Mocen-Bear/Mocen_Elevator_Ctrl/mech/renders/05_剖视_压下3mm.png

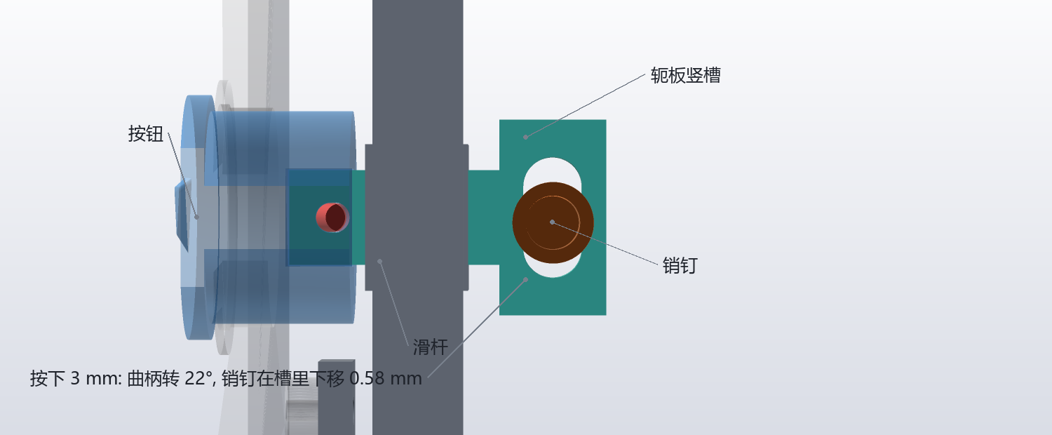
mech/renders/05_剖视_压下3mm.png
