Mocen-Bear/Mocen_Elevator_Ctrl/mech/renders/01_总装_正面.png

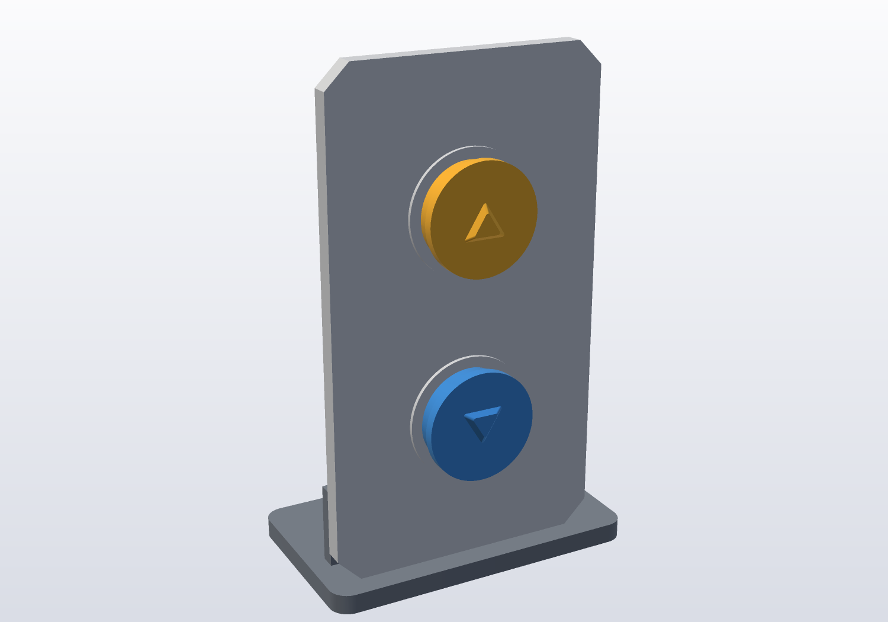
mech/renders/01_总装_正面.png
