Mocen-Bear/Mocen_Elevator_Ctrl/docs/README.md

# 文档索引

`docs/` 下所有文档的入口。按用途分三类：**协议接口**、**项目说明**、**子目录**。

---

## 协议与接口

| 文档 | 内容 |
|---|---|
| [`BLE_PROTOCOL.md`](BLE_PROTOCOL.md) | BLE 广播格式、服务/特征 UUID、命令与回执时序 |
| [`API.md`](API.md) | 对外接口约定（App 侧最小 HTTP 接口） |
| [`SHAFT_MODEL.md`](SHAFT_MODEL.md) | 井道 / 楼层空间模型与坐标约定 |
| [`NAV_APP_UI_SPEC.md`](NAV_APP_UI_SPEC.md) | 导航 App 界面规格（布局、状态、文案） |
| [`IOS_INTEGRATION.md`](IOS_INTEGRATION.md) | iOS 侧接入说明（同一套协议换实现） |

## 项目说明

| 文档 | 内容 |
|---|---|
| [`REPORT.md`](REPORT.md) | 项目技术报告（方案、取舍、实测数据） |
| [`HANDOVER.md`](HANDOVER.md) | 交接说明：现状、待办、红线 |
| [`术语表.md`](术语表.md) | 名词统一：井道、判层、合并镜像等 |

## 子目录

| 目录 | 内容 |
|---|---|
| [`android/`](android/) | App 安装说明与版本信息 |
| [`esp32/`](esp32/) | ESP32 开发环境搭建记录与环境交接 |
| [`media/`](media/) | 文档配图（接线、界面、3D 预览、增压装置） |
| [`项目资料/`](项目资料/) | 项目说明、技术说明、演示方案、分镜脚本 |
| [`演示材料/`](演示材料/) | 现场演示手册、能力与边界、版本信息 |

---

## 阅读顺序建议

1. 先看仓库根目录 [`README.md`](../README.md)，了解整体结构。
2. 想知道**怎么跑起来** → [`android/安装说明.md`](android/安装说明.md)、[`../firmware/烧录说明.md`](../firmware/烧录说明.md)。
3. 想知道**协议怎么对** → [`BLE_PROTOCOL.md`](BLE_PROTOCOL.md)。
4. 想知道**现场怎么讲** → [`演示材料/现场演示手册.md`](演示材料/)。
