Mocen-Bear/Mocen_Elevator_Ctrl/mech/参数与校验报告.md

# 演示样机 参数与校验报告 (v1)

> 由 `cad/build.py` 自动生成, 每次修改参数后重新生成。
> 坐标: X 右 / Y 上 / Z 朝墙里 (面板正面 Z=0)。单位 mm。

## 1. 关键尺寸

| 项目 | 数值 |
|---|---|
| 整机包围盒 | 82 宽 x 130 高 x 51 深 |
| 面板 | 70 x 125 x 5.0, 按钮孔 ⌀24.8, 上下中心距 51 |
| 按钮 | 帽 ⌀27.6 厚 2.6, 杆 ⌀24, 静止间隙 5, 工作行程 3, 硬限位 4 |
| 曲柄 | R=8, 厚 4.5, 轮毂 ⌀17, 花键孔 ⌀4.9, 销钉 ⌀6 |
| 轭槽 | 6.6 (行程向) x 13.6 (容差向), 销钉 6.0 -> 侧隙 0.6, 轴心高度容差 ±3.8 |
| 滑杆 | 5.0 x 10.6 |
| 舵机轴心 | Z=33.5 (比按钮中心低 8), 安装耳孔距 27.70 x2 |

## 2. 运动学

| 角度 | 行程 (mm) | 销钉中心下移 (mm) |
|---|---|---|
| 0° | 0.00 | 0.00 |
| 5° | 0.70 | 0.03 |
| 10° | 1.39 | 0.12 |
| 15° | 2.07 | 0.27 |
| 18° | 2.47 | 0.39 |
| 22° | 3.00 | 0.58 |
| 26° | 3.51 | 0.81 |
| 30° | 4.00 | 1.07 |

## 3. 干涉校验

在 0°~30° (行程 0~4 mm) 逐角度检查 4 个运动件 (曲柄+销钉 / 滑块 / 按钮 / 连接销)
它们**彼此之间**、以及每个与固定件 (底座 / 面板 / 舵机外形) 的布尔交集体积
(曲柄与销钉是设计上的过盈配合, 视为一个整体, 不互相检查)。

- 检查姿态数: **20**
- 最大干涉体积: **0.000000 mm³** -> **通过**
- 两层运动件 最小间隙: 23.40 mm

### 3.1 静止姿态实测间隙 (manifold 最小距离)

| 配合 | 实测间隙 |
|---|---|
| 销钉 ⌀6.0 → 竖槽侧壁 (槽宽 6.6) | 0.30 mm |
| 滑杆截面 → 按钮方孔 (5.4 x 11.0) | 0.20 mm |
| 滑杆截面 → 导向块方孔 (5.4 x 11.4) | 0.20 mm |
| 连接销 ⌀3.2 → 按钮横孔 ⌀3.4 | 0.10 mm |
| 连接销 → 滑杆横孔 | 0.10 mm |
| 按钮杆 ⌀24.0 → 面板孔 ⌀24.8 | 0.40 mm |
| 按钮后端 (z=11) → 导向块前端 (z=15.5) | 4.50 mm |
| 曲柄 (半径 13.5) → 底座 | 1.50 mm |
| 曲柄 + 销钉 → 舵机外形 | 0.00 mm |
| 轭板 → 底座导向块 | 0.20 mm |

## 4. 零件体积 (PLA 1.24 g/cm³)

| 零件 | 数量 | 体积 cm³ | 估重 g |
|---|---|---|---|
| 01_底座.stl | 1 | 33.42 | 41 |
| 02_面板.stl | 1 | 39.41 | 49 |
| 03_按钮_上.stl | 1 | 8.21 | 10 |
| 04_按钮_下.stl | 1 | 8.21 | 10 |
| 05_滑块.stl | 2 | 2.20 | 3 |
| 06_曲柄.stl | 2 | 1.01 | 1 |
| 07_销钉.stl | 2 | 0.59 | 1 |
| 08_连接销.stl | 2 | 0.25 | 0 |
| **合计** | **12 件** | **97.4** | **121** |

## 5. 结论

- 全行程无干涉, 全部零件均为单一水密实体, 可直接切片打印。
- 曲柄夹紧缝 + M3 夹紧螺丝: 可在装配时机械地对零, 无胶。
- 销钉为独立零件, 磨损/断裂只需重印 1 件, 不动曲柄。
- 竖槽 Y 向 ±3.8 mm 容差吸收舵机轴心高度误差。
