Mocen-Bear/Mocen_Elevator_Ctrl/docs/项目资料/01_说明文档.md

# 说明文档

> 本文件包含：项目名称 / 项目简介与功能说明 / 原创与版权声明 / 第三方标注。

---

## 一、项目名称

**中文名：电梯呼叫**
**英文名：Elevator Call**
**一句话副标题：基于蓝牙近场判层的"隔空按电梯"装置（ESP32 + 舵机 + Android）**

> 备选名（如需更项目化）：**「伸手」— 让电梯先听见你** / **ELEV-CALL 无接触呼梯**
> （最终用哪个名字，由项目维护者决定；本文件其余部分与名字无关。）

---

## 二、项目简介与功能说明

### 2.1 项目简介（300 字以内，可直接粘贴用）

> 在电梯厅外，人要做的事只有一件：**按一下呼梯按钮**。但对提着重物、抱着孩子、
> 或者暂时腾不出手的人来说，这一下并不轻松，也不卫生。
>
> 我们做了一套**零改造**的呼梯装置：手机 App 打开即自动扫描，用**蓝牙广播信号的强弱**
> 判断"你正站在哪一层、离井道多近"，然后把该层电梯的**真实呼梯按钮**用舵机按下去。
> 装置通身只有一个"贴在墙上"的 3D 打印支架 + 一块 ESP32 + 一个舵机，**不碰电梯任何线路**、
> **10 秒可拆**，全部**离线可用**、**零预算**。
>
> 关键是**我们不自称能做到做不到的事**：我们只按公共按钮、不控制电梯；
> 收到 `1F|OK:UP` 只代表"舵机动作完成"，**不代表轿厢动了**。
> 凡是我们测不到的（轿厢真实位置、还有几秒到），界面上要么不显示，要么明确标注来源。

### 2.2 功能说明（按"用户看到什么"写）

| # | 功能 | 用户看到 / 体验到什么 | 技术上是怎么做出来的 |
|---|---|---|---|
| 1 | **打开即用** | 打开 App 就开始工作，**不用配对、不用扫码、不用点"开始搜索"** | 手机持续扫描 BLE 广播（不建立连接），每扫到一次新广播就立刻重判，节流 40 ms |
| 2 | **自动认楼层** | 顶部层显自动变成"你所在楼层"（1F / 2F），3D 井道里对应楼层高亮 | 按 RSSI 强弱 + 中位数窗口 + EMA + 3 dB 滞回 + 连赢计数，四道防抖 |
| 3 | **隔空呼梯** | 点 **▲ 上行 / ▼ 下行**，该层的真按钮被**真的按下去** | 手机 → BLE 写 `UP`/`DOWN` → 该层 ESP32 → D13/D12 出 50 Hz PWM → 舵机转 22° 压按钮 |
| 4 | **真回执** | 界面提示 `1F \| OK:UP`（表示**舵机动作完成**） | ESP32 通过 Notify 特征**广播**回执，所有已订阅的手机都能收到 |
| 5 | **多人同时用** | 一块 ESP32 最多 **3 台手机**同时连接、各自控制，互不影响 | 固件 v5 起：断开一台不影响其它手机收通知 |
| 6 | **看得见的 3D 井道** | 可手指拖动旋转的 B–3F 电梯井；轿厢会动，到站自动开门；**只有 1F/2F 画全**，B/3F 是半透明虚影 | 安卓端软件渲染（自写投影 + painter 排序），几何常量与规格页逐条对齐 |
| 7 | **两台电梯** | 甲梯**跟着你**（你在哪层它就在哪层），乙梯**随机跑**（纯装饰） | 乙梯的随机**只发生在界面里**，接口里 `car2` 恒为 `null`（不知道就说不知道） |
| 8 | **给队友 App 的接口** | 队友的 iOS 导航 App 直接 HTTP 调 `/api/call?floor=1F&dir=UP` | 安卓端内置 `LocalApiServer`（8899），和点按钮**走同一条代码路径** |
| 9 | **安全红线（写进代码里的）** | 永远不会"自己乱按" | ① 全工程只有 **2 个**能发命令的入口（▲/▼ 按钮、HTTP 接口）；② 信号/判定回调里**一行发命令的代码都没有**；③ `tryCall()` 第一句就拒绝 B/3F；④ 换楼层只改 UI，从不自动呼梯 |

### 2.3 我们**明确做不到**的（主动写在最前面，也是设计的一部分）

| 做不到 | 为什么 | 我们怎么处理 |
|---|---|---|
| 测不出轿厢真实在哪层 | 两块 ESP32 只会"按按钮"，电梯不给我们任何反馈 | 界面**永远标来源**；没装传感器时明确是"蓝牙判层/模拟" |
| 控制不了电梯 | 没有授权、也没有接口 | 我们只做**厅外呼梯**，等于把"有人伸手按一下"自动化 |
| 不知道还有几秒到 | 同上 | **不显示**这类假数据 |
| 现场没有网络也 OK | —— | App 全程 BLE，不需要服务器；网页预览全是本地文件 |

---

## 三、原创与版权声明

> **声明：本项目代码、硬件结构、机械结构、演示素材均为本队原创，不存在抄袭、剽窃行为。**

具体原创清单（每一项都能在仓库里逐行查到）：

| # | 原创产物 | 位置 | 说明 |
|---|---|---|---|
| 1 | **Android App 全部源码**（Kotlin） | `android/app/src/main/java/com/mocen/elevator/` | 15 个文件全部自写：BLE 扫描/连接、楼层判定、3D 电梯井软件渲染、对外 HTTP 接口、摄像头点阵识别等 |
| 2 | **ESP32 固件**（两块板 + 可选的"听叮声"节点） | `firmware/elevator_1F/`、`elevator_2F/`、`chime_node/` | 自写 BLE 服务/特征、命令解析、舵机 PWM（**只用 ESP32 核心自带的 LEDC，无第三方舵机库**） |
| 3 | **机械结构（3D 打印件）** | `mech/cad/build.py` | **参数化 CAD + 干涉自检 + 光栅渲染器全部自写**（本机没有 OpenSCAD/Blender，我们直接用 numpy 写了实体建模 + z-buffer 渲染 + 逐件间隙校验） |
| 4 | **网页预览 / 演示台 / 演示页** | `preview/*.html` | 全部**手写 HTML/CSS/JS**，无任何前端框架；3D 井道是 canvas 软件渲染 |
| 5 | **协议与规格文档** | `BLE_PROTOCOL.md`、`API.md`、`SHAFT_MODEL.md`、`NAV_APP_UI_SPEC.md` 等 | 自写 |
| 6 | **口播稿 / 常见问答 / 演示脚本** | `演示材料/`、`项目资料/` | 自写 |

**素材声明**：
- 本项目**没有使用任何第三方图片、音乐、视频、字体文件作为分发内容**。
- 演示幻灯片中的配图，**全部由我们自己的 CAD/网页工具生成**（`mech/renders/*.png`、`preview/*.html` 截图）。
- 渲染文字时**临时**调用了本机 Windows 系统自带的中文字体（微软雅黑等），**仅用于生成图片，未随包分发字体文件**。
- **没有使用任何第三方 AI 模型权重、任何公开数据集**（见第四部分"模型/数据集"一栏写"无"）。

**授权**：本项目愿意按文档要求公开源码供对方审阅；如需开源，拟采用 **MIT 许可证**
（**注意**：是否开源、用哪个许可证，由项目维护者确认）。

---

## 四、第三方开源库 / 工具 / API / 模型 / 数据集 —— 完整标注来源

> 要求：**完整标注来源**。下面是**全量清单**（按运行环境分组）。
> 所有条目均为**公开开源软件 / 系统自带能力**，且都只用在"辅助工具链"上；
> **没有第三方 AI 模型、没有公开数据集、没有收费 API、没有商业 SDK**。

### 4.1 手机端（Android App）

| 名称 | 版本 | 用途 | 来源 / 许可证 |
|---|---|---|---|
| Kotlin 标准库 | 1.9.x（随 Gradle 8.7 / AGP） | 语言运行时 | JetBrains · Apache-2.0 |
| AndroidX Core KTX | 1.13.1 | Android 基础扩展 | Google · Apache-2.0 |
| AndroidX AppCompat | 1.7.0 | 兼容性 Activity | Google · Apache-2.0 |
| AndroidX ConstraintLayout | 2.1.4 | 布局 | Google · Apache-2.0 |
| AndroidX RecyclerView | 1.3.2 | 列表 | Google · Apache-2.0 |
| Google Material Components | 1.12.0 | Material 控件与图标 | Google · Apache-2.0 |
| Android SDK / Jetpack（系统能力） | API 34 编译 | 蓝牙 BLE、相机、权限 | Google · Android SDK 许可 |
| Gradle + Android Gradle Plugin | Gradle 8.7 | 构建 | Gradle Inc. / Google · Apache-2.0 |
| JDK（Zulu / OpenJDK 17） | 17.0.20.1 | 编译运行 | Eclipse Temurin/Zulu · GPLv2+CE |

> 说明：Android App **没有**使用任何第三方 UI 框架、网络框架、图片库；
> BLE、相机、HTTP 服务器全部用 **Android 系统自带 API** 自己实现。

### 4.2 装置端（ESP32 固件）

| 名称 | 版本 | 用途 | 来源 / 许可证 |
|---|---|---|---|
| ESP32 Arduino Core（含 `BLEDevice/BLEServer/BLEUtils/BLE2902`） | core 2.x / 3.x 均兼容 | BLE 服务、GPIO | Espressif · LGPL-2.1 |
| FreeRTOS（随 core 内置） | 随 SDK | 队列/任务 | FreeRTOS · MIT |
| ESP32 芯片自带 **LEDC** 外设 | —— | 产生舵机 50 Hz PWM | 芯片能力，**未使用第三方舵机库** |

> 说明：固件**刻意不用 `ESP32Servo` 等第三方舵机库** —— 直接用核心自带 LEDC，
> 这样 core 2.x / 3.x 都能编译（源码注释里写了原因）。

### 4.3 电脑端工具链（只用于**生成**模型/图/PPT/视频，不是产品本身）

| 名称 | 用途 | 来源 / 许可证 |
|---|---|---|
| Python 3.12 | 建模 / 渲染 / 出图 / 出片 | PSF · PSF-2.0 |
| NumPy | 数值、几何、栅格渲染 | NumPy 团队 · BSD-3 |
| Pillow | 图像合成与标注 | Pillow · HPND（MIT 类） |
| **manifold3d** | 实体布尔运算（CAD 内核） | Emmett Lalish · Apache-2.0 |
| **trimesh** | STL 网格读写与校验 | Michael Dawson-Haggerty · MIT |
| **python-pptx** | 生成幻灯片 `.pptx` | Steve Canny · MIT |
| **OpenCV** | 生成演示视频（逐帧写 MP4） | OpenCV · Apache-2.0 |
| **imageio + imageio-ffmpeg** | 视频编码（内置 ffmpeg 二进制） | imageio · BSD-2；ffmpeg · LGPL/GPL |
| **dulwich** | 纯 Python 生成 Git 仓库与 bundle | Jelmer Vernooij · Apache-2.0 / GPL-2.0 |
| Node.js v24 | 本地静态预览服务器 | OpenJS · MIT |
| Windows 系统字体（微软雅黑/黑体等） | 仅在渲染图片时使用 | 微软系统自带，**未随包分发** |

> ⚠️ 上面这些是**我们做项目和做材料时用的工具**，不是交付物的一部分。
> 其中 `manifold3d` / `trimesh` / `python-pptx` / `dulwich` 是本次为了"本机没有 OpenSCAD、没有 Blender、没有 git"
> 而临时安装的开源库；**项目结束后不随产品发布**。

### 4.4 API / 云服务 / 大模型 / 数据集

| 类别 | 使用情况 |
|---|---|
| 第三方 Web API / 云服务 | **无**（App 全程 BLE + 本机 HTTP，离线可用） |
| 第三方 AI 大模型（作为产品功能） | **无**（App v10 已把语音识别整条删除，理由：手机自带识别在现场不可靠） |
| 第三方模型权重 / 预训练模型 | **无** |
| 公开数据集 | **无**（楼层判定用的是自建的室内 BLE 传播仿真模型，代码在 `preview/rssi_floor_sim.html`） |
| 浏览器 API | Web Bluetooth（`ble_console.html` 备用调试台）· W3C 标准 |

### 4.5 一次性出处声明（模板，按需抄进别的材料）

> 本项目使用的第三方开源软件已在《说明文档》第五部分按其许可证标注；
> 本项目未使用任何第三方 AI 模型权重与公开数据集；
> 若对方需要，我们可以提供 `pip list` / `gradle dependencies` 的完整依赖树作为凭证。

---

## 五、附：本文件与其它材料的关系

| 材料 | 对应文件 |
|---|---|
| 01 说明文档 | **本文件** |
| 02 项目内容（代码仓库 + 技术文档 + 第三方标注） | `02_项目内容.md` |
| 03 展示内容（PPT / 演示视频 / 现场方案 + 备用材料） | `03_展示内容.md` |
