Mocen-Bear/Mocen_Elevator_Ctrl/docs/项目资料/02_项目内容.md

# 项目内容

> 本文件包含：代码仓库 / 技术说明文档 / 第三方工具·开源库·API·模型·数据集说明。

---

## 一、代码仓库

| 项目 | 内容 |
|---|---|
| 公开仓库 | <https://github.com/Mocen-Bear/Mocen_Elevator_Ctrl> |
| 默认分支 | `main` |
| 提交历史 | `git log` 可查 |

```bash
git clone https://github.com/Mocen-Bear/Mocen_Elevator_Ctrl.git
```

### 1.1 仓库里有什么（从哪里看起）

```
Mocen_Elevator_Ctrl/
├── README.md               ← 项目总说明：物料、接线、烧录、App 使用、演示脚本
├── docs/                   ← 技术文档：报告 / BLE 协议 / HTTP 接口 / 井道几何 / 交接说明
├── android/                ← Android App（Kotlin）完整工程，Android Studio 可直接打开
├── firmware/
│   ├── elevator_1F/        ← 1F 板固件（D13 上行 / D12 下行）
│   ├── elevator_2F/        ← 2F 板固件（同上，仅楼层名不同）
│   └── chime_node/         ← 可选加装件：听电梯"叮"声判到站
├── mech/                   ← 3D 打印演示样机：参数化 CAD + 自写渲染器 + STL
├── preview/                ← 离线网页：演示台 / 3D 井道 / 判定仿真 / 蓝牙控制台
├── packages/               ← 按对象打包的文档与代码副本
├── presentation/           ← 幻灯片源文件
├── releases/               ← 发布说明
└── tools/                  ← 自检与生成脚本
```

### 1.2 怎么把代码跑起来（复现步骤）

| 想做什么 | 怎么做 | 需要什么 |
|---|---|---|
| **最快：看演示** | 双击 `preview/index.html`（或用任意静态服务器打开） | **什么都不用装**，纯本地文件 |
| 看控制链 3D | 双击 `preview/elevator_3d_model.html` | 同上 |
| 编译 App | Android Studio 打开 `android/`，或 `gradlew assembleDebug` | JDK 17 + Android SDK |
| 烧固件 | Arduino IDE 打开 `firmware/elevator_2F/elevator_2F.ino` | Arduino IDE + ESP32 支持包（core 2.x/3.x 都行） |
| 重新生成机械模型 | `python mech/cad/build.py` | numpy / manifold3d / trimesh / Pillow（4 个开源库，见第四部分） |

> **注意**：仓库里**不含 APK 与固件压缩包**（那是构建产物）。需要手机安装包时按
> `docs/android/安装说明.md` 自行构建，仓库只保留纯源码。

---

## 二、技术说明文档

> 全部为**中文自写文档**，都在仓库里。下表按"最想先看的顺序"排。

| # | 文档 | 讲什么 | 在哪 |
|---|---|---|---|
| 1 | **`README.md`** | 总入口：物料清单、接线表、烧录步骤、App 编译安装、使用与演示脚本、目录结构、BLE 协议、对外接口 | 仓库根目录 |
| 2 | **`docs/项目资料/01_说明文档.md`** | 项目简介与功能、能力边界、原创声明、第三方标注 | 本目录 |
| 3 | **`docs/项目资料/03_展示内容.md`** | PPT / 演示视频 / 现场运行方案 / 备用材料 | 本目录 |
| 4 | **`docs/项目资料/3D电梯控制模型方案.md`** | 3D 模型这一版的选型与做法（含三方案比较与结论） | 本目录 |
| 5 | **`docs/BLE_PROTOCOL.md`** | 蓝牙协议规格：UUID、命令集、回执格式、判层规则、多机并发、Swift 示例 | `docs/` |
| 6 | **`docs/API.md`** | 对外 HTTP 接口：`/api/ping` `/api/floors` `/api/status` `/api/call` `/api/target` + JSON 示例 | `docs/` |
| 7 | **`docs/SHAFT_MODEL.md`** | 3D 井道的**几何规格**：尺寸、逐件配色、全息材质配方、2D→3D 投影公式（安卓 / 网页 / AR 共用） | `docs/` |
| 8 | **`docs/CAR_POSITION.md`** | "轿厢真实在哪层"的两条路：摄像头读楼层显示、听"叮"声判到站（含标定方法） | `docs/` |
| 9 | **`docs/NAV_APP_UI_SPEC.md`** | 悬浮呼梯按钮的交互规格（给 iOS 队友，含 SwiftUI 骨架） | `docs/` |
| 10 | **`docs/HANDOVER.md`** | 交接说明：怎么操作、怎么跟 AI agent 说 | `docs/` |
| 11 | **`mech/说明书_装配与使用.md`** | 3D 打印样机的装配顺序、打印朝向、使用与标定 | `mech/` |
| 12 | **`mech/参数与校验报告.md`** | 参数表 + **自动生成的干涉校验报告**（20 个姿态下最大干涉 0.000000 mm³、各处配合间隙表） | 同上 |
| 13 | **`docs/演示材料/能力与边界.md`** | 一页纸"能做到 / 做不到 / 常见追问怎么答" | `docs/演示材料/` |
| 14 | **`docs/演示材料/现场演示手册.md`** | 3 分钟现场脚本、出问题对照表、问答表、出发前清单 | 同上 |
| 15 | **`docs/REPORT.md`** | 开发过程记录 | `docs/` |

### 2.1 建议优先看的三个"可交互"证据

| 文件 | 看什么 |
|---|---|
| `preview/elevator_3d_model.html` | **3D 控制链**：点 ▲/▼，整条链（App→BLE→ESP32→舵机 22°→按钮后移 3.00mm→轿厢到站开门）按顺序点亮；含机构剖视（尺寸按真值） |
| `preview/rssi_floor_sim.html` | **楼层判定的离线仿真**：同一套算法 + 室内传播模型 + 噪声，可现场调参看"抖不抖" |
| `preview/storyboard.html` | **30 秒产品演出**（按 F 进放映模式），演示/录屏用 |

---

## 三、第三方工具 / 开源库 / API / 模型 / 数据集 —— 说明

> 完整逐条清单（含版本号与许可证）在 **`01_说明文档.md` 第四部分**。这里给的是"速查版"。

### 3.1 产品本身用到的第三方（都是系统自带能力 / 公开开源）

| 层 | 用了什么 | 许可证 | 说明 |
|---|---|---|---|
| Android App | **AndroidX**（core-ktx / appcompat / constraintlayout / recyclerview）+ **Google Material Components** | Apache-2.0 | 基础控件与 Material 组件；**没有**任何第三方网络库、图片库、框架 |
| Android App | Kotlin 标准库、Android SDK 的 **BLE / Camera / HttpServer** 能力 | Apache-2.0 / Android SDK | 蓝牙、相机、对外 HTTP 接口**全部用系统 API 自己实现** |
| ESP32 固件 | **ESP32 Arduino Core**（`BLEDevice`/`BLEServer`/`BLEUtils`/`BLE2902`）+ **FreeRTOS** | LGPL-2.1 / MIT | 芯片厂商官方核心；**刻意不用第三方舵机库**，直接用核心自带 LEDC 出 50Hz（core 2.x/3.x 都能编译） |
| 网页 | 浏览器自带的 **Canvas 2D** / **Web Bluetooth**（W3C 标准） | — | 全部页面**手写 HTML/CSS/JS，零框架、零 CDN** |

### 3.2 做模型 / 做材料时用的工具链（**不是产品的一部分**）

| 名称 | 用途 | 许可证 |
|---|---|---|
| Python 3.12 · NumPy · Pillow | 参数化建模、自写 z-buffer 渲染器、出图 | PSF-2.0 / BSD-3 / HPND |
| **manifold3d**（CAD 内核）· **trimesh**（网格） | 实体布尔运算、STL 读写与校验 | Apache-2.0 / MIT |
| **python-pptx** | 生成幻灯片 `.pptx` | MIT |
| **OpenCV** · **imageio + imageio-ffmpeg** | 生成演示视频（逐帧写 MP4 + 编码） | Apache-2.0 / BSD-2 / LGPL |
| **dulwich** | 本机没有 git，用纯 Python 生成 git 仓库与 bundle | Apache-2.0 / GPL-2.0 |
| Node.js | 本地静态预览服务器 | MIT |
| Windows 系统字体（微软雅黑等） | **仅**在渲染图片时调用，**未随包分发字体文件** | 系统自带 |

> 说明：这台机器上没有 OpenSCAD、没有 Blender、没有 git 命令行 —— 所以机械模型的
> 实体建模 / 渲染 / 校验、以及 git 仓库的生成，都是**用自己的脚本 + 上述开源库**完成的。

### 3.3 API / 云服务 / 大模型 / 数据集

| 类别 | 结论 |
|---|---|
| 第三方 Web API、云服务、付费 SDK | **无**（App 走 BLE + 本机 HTTP，**离线可用**；现场断网也能演） |
| 第三方 AI 大模型（作为产品功能） | **无**。App 曾在 v7 做过语音呼梯，**v10 已把语音整条删除**（真机上手机自带识别对"去三楼/上行"这类短句不稳），按钮、代码文件、麦克风权限一并删掉 |
| 第三方模型权重 / 预训练模型 | **无** |
| 公开数据集 | **无**。楼层判定用的是**我们自建的室内 BLE 传播仿真模型**（代码就在 `preview/rssi_floor_sim.html`，可现场跑） |
| 训练 / 微调 | **无**（全项目没有任何模型训练环节） |

### 3.4 第三方依赖声明（可直接引用）

> 本项目使用的第三方组件仅为 AndroidX / Google Material / ESP32 Arduino Core / FreeRTOS
> 等公开开源软件（均按其许可证标注，完整清单见《说明文档》第四部分）。
> 项目**未使用任何第三方 AI 模型权重、未使用任何公开数据集、未接入任何付费 API 或云服务**；
> 全部功能（蓝牙判层、呼梯、3D 井道、机械结构、文档与演示材料）均为本项目原创。
> 如需核对，可提供 `gradle dependencies` 与 `pip list` 的完整依赖树作为凭证。
