Mocen-Bear/Mocen_Elevator_Ctrl/docs/项目资料/_版本信息.md

# 项目资料 · 目录说明

| 项 | 值 |
|---|---|
| 目录 | `docs/项目资料/` |
| 版本 | v1（2026-10-18） |

---

## 里面有什么

| 文件 | 内容 |
|---|---|
| `01_说明文档.md` | 项目名称、简介、功能说明、软硬件组成、第三方依赖总表 |
| `02_项目内容.md` | 仓库结构、目录树、复现步骤、技术文档索引 |
| `03_展示内容.md` | 演示视频、现场运行方案、备用演示材料 |
| `3D电梯控制模型方案.md` | 3D 模型方案书 |
| `演示视频_分镜脚本.md` | 逐镜口播稿 + 拍摄清单 |
| `_版本信息.md` | 本文件 |

---

## 这些材料怎么来的（本机产物，可复核）

| 产物 | 做法 | 来源 |
|---|---|---|
| 9 张 CAD 图 + 8 个 STL | 本机 Python + numpy 自写光栅渲染器（未使用 OpenSCAD / Blender） | `mech/cad/build.py`、`render.py` |
| 尺寸 / 间隙 / 干涉数据 | 同一份 `build.py`（20 个位姿逐对检查） | `mech/参数与校验报告.md` |
| 演示视频 | 本机 `cv2` + `imageio/libx264` 逐帧合成 | 临时脚本 `make_video.py`（不在仓库内） |
| PPT | 本机 `python-pptx` | 插图即上面的 CAD 图 |

---

## 变更记录

| # | 什么时候 | 改了什么 |
|---|---|---|
| 1 | 2026-10-18 | 目录首版。 |
| 2 | 2026-10-18 | 补本文件；同步固件 v6 的舵机角度（90° → 100°）。 |

> 固件版本与角度演进见 `firmware/_版本信息.md`；本目录只存说明材料，不随固件版本重建。
