Mocen-Bear/Mocen_Elevator_Ctrl/docs/项目资料/演示视频_分镜脚本.md

# 演示视频 · 分镜脚本（含口播稿）

> 本文件同时是**两样东西的说明书**：
> ① 成片 `演示视频_备用.mp4`（**2 分 32 秒**，无配音、字幕驱动）的逐帧分镜；
> ② 现场**要补拍真机版视频**时的拍摄脚本 —— 把下面"口播稿"照着念、把"补拍镜头"换成实拍即可，
> 成片时长控制在 **3 分钟以内**，满足"≤ 8 分钟"的要求还有大量余量。
>
> **为什么这版没有配音**：我们手上没有真机（电梯是公共设施，装置只能到现场再贴），
> 也没有真人录音条件。**字幕就是完整口播稿** —— 对方静音看也信息完整，有声看也能照着念。
> 这条取舍在 `03_展示内容.md` 里也写明了，不藏着。

| 项 | 值 |
|---|---|
| 文件 | `media/demo/演示视频_备用.mp4` |
| 时长 | 152.0 秒（2 分 32 秒） |
| 画面 | 1280 × 720，25 fps，H.264（libx264，yuv420p） |
| 体积 | 约 5.1 MB |
| 音轨 | **无**（字幕即口播稿） |
| 素材来源 | 全部为本机真实产物：自写渲染器输出的 9 张 CAD 图 + 按真值运动学实时绘制的机构剖视；**没有一张网图、没有一张 AI 生成图** |

---

## 总览

| # | 时间 | 场景 | 标题 | 这一段要证明什么 |
|---|---|---|---|---|
| 1 | 0:00 – 0:08 | 封面 | 电梯呼叫 · 基于蓝牙近场判层的「隔空按电梯」装置 | 我们是谁、做什么 |
| 2 | 0:08 – 0:26 | 问题 | 一、要解决的问题 | 为什么值得做 |
| 3 | 0:26 – 1:04 | 控制链 | 二、呼一次，整条链是怎么走的 | **命令是真的、链路是通的** |
| 4 | 1:04 – 1:20 | 机构特写 | 三、机构特写（尺寸全部是真值） | 按钮**真的被物理按下去了** |
| 5 | 1:20 – 2:02 | 实物样机 | 四、可 3D 打印的实物样机（9/9） | 这不是 PPT，是能打印出来的东西 |
| 6 | 2:02 – 2:22 | 能力边界 | 五、能力与边界（先说做不到的） | 主动交代边界 = 可信 |
| 7 | 2:22 – 2:32 | 结尾 | 呼梯是真的 / 位置测不到，就标出来 | 一句话记住我们 |

---

## 镜 1 · 封面　0:00 – 0:08

- **画面**：深色底 + 两个同心圆（电梯井的抽象符号）。中间两行大字，2.4 秒后浮出第三行。
- **屏幕文字（字幕原样）**：
  - 主标题：`电梯呼叫`
  - 副标题：`基于蓝牙近场判层的「隔空按电梯」装置`
  - 第三行：`ESP32 + 舵机 + Android · 零改造 · 离线可用 · 全程手动`
  - 2.4 秒后浮出：**`呼梯是真的，位置测不到就标出来。`**
  - 3.6 秒后小字：`—— 我们的能力边界，也是最硬的设计原则`

> **口播稿**（约 8 秒）
> "电梯厅里，人要做的事只有一件：按一下呼梯按钮。我们把这个动作自动化了 ——
> 不碰电梯任何线路。**呼梯是真的，位置测不到，我们就标出来**，这是我们的原则。"

- **如果要补拍真机版**：把这一镜换成"手机贴近呼梯面板、按钮自动浮出"的手持特写，不加任何后期特效，越朴素越可信。

---

## 镜 2 · 问题　0:08 – 0:26

- **画面**：三条卡片依次淡入（每条间隔 1.5 秒），5.4 秒后底部浮出绿色结论卡。
- **屏幕文字**：

| 左（现象） | 右（要点） |
|---|---|
| 提着重物 / 抱着孩子 / 手里腾不出来 | 这一下，其实不轻松 |
| 公共按钮，谁来都按 | 也不卫生 |
| 现有方案：改电梯、装传感器、动线路 | 要授权、要施工、要钱 |

- 结论卡：`我们的答案：不改电梯任何线路，只把「有人伸手按一下」自动化。`
- 小字：`装置贴在墙上，10 秒可拆；全程离线、零预算。`

> **口播稿**（约 18 秒）
> "手里拎着东西、抱着孩子、戴着厚手套的时候，那一个按钮就是按不到。
> 公共按钮谁来都按，也不卫生。
> 现有做法要么改造电梯、要么装传感器、要么动线路 —— 都要授权、要施工、要钱。
> 我们的答案很简单：**不改电梯任何线路，只把「有人伸手按一下」这件事自动化**。
> 装置用胶带贴在墙上，10 秒可拆；全程离线，零预算。"

---

## 镜 3 · 控制链　0:26 – 1:04（重点镜）

这一镜 38 秒，内部**循环 2 次半**，一个循环 15 秒，按真实时序走完 6 步。

- **画面**：上方 6 枚芯片依次点亮（未点亮的保持灰暗）；左下是按楼层排列的井道示意（B–3F，只有 1F/2F 带 `◉ 装置` 标记，轿厢从 3F 平移下来，到站后开门缝）；右侧是**机构剖视**（按钮 / 滑杆 / 轭板竖槽 / 销钉 / 曲柄），随舵机角度**实时运动**；下方是回执日志。

- **一个循环内的时序与字幕**：

| 循环内时刻 | 点亮的芯片 | 回执日志 | 屏幕字幕（口播稿） |
|---|---|---|---|
| 0.0 – 1.6 s | 全暗 | —（空） | `你先点一下 ▲ 上行 —— 从这一刻起才有命令` |
| 1.6 s | 手机 App | `→ 手机 App：点了 ▲ 上行（你所在 = 1F，来源：蓝牙判层）` | 同上 |
| 3.0 s | BLE 写入 | `→ BLE 写入 "UP" → ELEV-1F` | `手机把 UP 写进蓝牙特征` |
| 4.1 s | ESP32 | `→ ESP32 收到：拉 D13 出 50Hz PWM` | `装在该层的 ESP32 收到，拉 D13 出 50Hz PWM` |
| 5.0 – 5.95 s | 舵机转 22° | 同上 | `舵机转 22°；曲柄的销钉在竖槽里滑，推着滑杆走` |
| 5.95 – 6.3 s | 按钮后移 3mm | `→ 1F\|OK:UP （= 舵机动作完成，不是"车动了"）` | `滑杆把按钮往后拉 3.00 mm —— 按钮真的被按下去了` |
| 8.2 – 12.6 s | 轿厢过来 | `→ 轿厢开过来：目标 1F` | `收到回执：舵机动作完成；轿厢开过来、到站开门` |
| 12.6 s | 全部点亮 | `✓ 到站 1F，开门` | 同上（轿厢门缝张开） |

> **口播稿**（把上面 6 句连起来念，一遍约 15 秒，全镜念两遍）
> "你在 App 上点一下 ▲ 上行 —— 注意，**从这一刻起才有命令**。
> 手机把 `UP` 这个字符串写进蓝牙特征；装在该层的 ESP32 收到，对应引脚拉出 50Hz 的舵机信号；
> 舵机转 22°，曲柄上的销钉在竖槽里滑，把滑杆推出去；
> 滑杆把按钮往后拉 3 毫米 —— **按钮真的被按下去了**，呼梯灯亮。
> 手机收到回执：舵机动作完成。轿厢开过来，到站、开门。
> 全程只有两个能发命令的入口：你点的那两下，或者 HTTP 接口。**没有任何定时器会自己帮你按。**"

- **补拍真机版要点**：手机屏幕录制（按钮浮出→点击）+ 侧面机位拍舵机臂推出 + 正拍呼梯灯亮起。三路画中画。

---

## 镜 4 · 机构特写　1:04 – 1:20

- **画面**：一张真实比例剖视，横轴是"往墙里"的方向、纵轴是上下，**左边按钮、右边曲柄，同一把比例尺**。6 秒一个循环：静止 → 0.35 秒转到 22° → 保持 0.6 秒 → 0.35 秒回位。
- **屏幕文字**：
  - 标题：`三、机构特写（尺寸全部是真值）`
  - 副标题：`曲柄 R=8mm · 行程 = R·sinθ · 22° → 3.00mm · 硬限位 4.00mm(30°)`
  - 实时读数条：`曲柄 θ = 22.0°`　`销钉位移 t = 3.00 mm`　`销钉横向下垂 0.58 mm`　`按钮后移 = t（刚性连接）`
  - 图内标注：`t = 3.00 mm`（行程尺寸线）、`帽背到凸圈 1.00mm（顶到 0 就是硬限位）`、`销钉下垂 X mm（被 13.6mm 竖槽吸收）`
  - 图例：`曲柄 / 销钉 / 轭板·竖槽 / 滑杆 / 按钮 / 面板(剖)`
  - 底部字幕：**`销钉只走直线、不摆动 —— 这是斯科奇轭（Scotch yoke）的意义：按钮不受侧向力`**

> **口播稿**（约 16 秒）
> "这是机构的真实比例剖视，尺寸全是程序算出来的，不是画着好看的示意图。
> 曲柄半径 8 毫米，转 22 度，行程正好 3 毫米 —— 就是 `行程 = R × sinθ`。
> 销钉在一条 13.6 毫米长的竖槽里滑，**只走直线、不上下摆动**，所以按钮完全不受侧向力 ——
> 这是斯科奇轭的经典优点。
> 按钮帽背面顶到凸圈就是硬限位，4 毫米，**不是靠舵机堵转来限位**。
> 连接销把按钮和滑杆刚性钉死：万一有人用力过猛，是反推舵机，而不是把塑料件掰坏。"

---

## 镜 5 · 可 3D 打印的实物样机　1:20 – 2:02（9 张图，每张约 4.7 秒）

- **画面**：9 张自写渲染器输出的 CAD 图，依次全屏展示（整张完整可见、不裁边），缓推 2~3%；左上角计数 `四、可 3D 打印的实物样机（k/9）`，左上角副标题是这张图的要点，左下角是图名。

| # | 时间 | 图 | 屏幕要点 |
|---|---|---|---|
| 1 | 1:20.0 | `01_总装_正面.png` | 装到墙上就是这个样子：面板 + 上/下两个按钮 |
| 2 | 1:24.7 | `02_总装_背面.png` | 舵机在 −X 侧，两层按钮各自一套曲柄+轭 |
| 3 | 1:29.3 | `03_机构特写.png` | 曲柄、销钉、竖槽、导向块、连接销 |
| 4 | 1:34.0 | `04_剖视_静止.png` | 静止时按钮帽与面板留 5mm 间隙，不是一直贴着按 |
| 5 | 1:38.7 | `05_剖视_压下3mm.png` | 22° 时按钮被拉进去 3.00mm，帽背顶到凸圈就是硬限位 |
| 6 | 1:43.3 | `06_爆炸图.png` | 8 个件，全部免胶：打印销 + 螺丝固定 |
| 7 | 1:48.0 | `07_零件一览.png` | 底座 33.4cm³、面板 39.4cm³、按钮 8.2cm³…合计约 97cm³ / 120g PLA |
| 8 | 1:52.7 | `08_打印摆放.png` | Bambu Lab A1 直接排好：面板背面朝下、按钮杆朝下 |
| 9 | 1:57.3 | `09_原理图.png` | 行程 = R·sinθ；销钉轨迹半径 R=8mm，行程 3.00mm 对应 22° |

> **口播稿**（约 42 秒，可挑着说）
> "为什么要做这个机械样机？因为对方想看的不是一段动画，而是**按钮真的被按下去了**。
> 墙上不允许我们贴真电梯，那我们就在自己的板子上做一个真按钮的替代品。
> 整机 82 × 130 × 51.4 毫米，8 个零件，**全部免胶**：能用打印销压配的就压配，要受力的就用 M3 螺丝。
> 打印摆放已经排好了，Bambu Lab A1 直接开打：面板背面朝下、按钮杆朝下，帽面上的上下箭头才印得出来。
> 干涉检查跑了 20 个位姿，最大重叠体积 0.000000 立方毫米。"

- **补拍真机版要点**：如果演示前 3D 打印件已经打出来，这一段直接换成**打印、装配、手按测试**的实拍，信息量比渲染图更大。

---

## 镜 6 · 能力与边界　2:02 – 2:22

- **画面**：上下两张卡片。绿色卡片逐条浮出 3 条"真能做到"；红色卡片逐条浮出 3 条"明确做不到"；5.6 秒后底部字幕。
- **屏幕文字**：
  - 标题：`五、能力与边界（先说做不到的）`
  - 副标题：`这个项目最容易被问穿的一句话是：你怎么知道电梯在几楼`
  - 绿卡 `我们真能做到的`：
    1. `真的把按钮按下去：舵机物理按压，不是模拟点击`
    2. `不用配对：靠 BLE 广播的 RSSI 判断你在哪层，40~200ms`
    3. `只有 2 个能发命令的入口：▲/▼ 按钮、HTTP 接口 —— 没有任何定时器自动呼梯`
  - 红卡 `我们明确做不到的（必须先说）`：
    1. `测不出轿厢真实位置（电梯不给我们任何反馈）`
    2. `控制不了电梯 —— 我们只做厅外呼梯，等于替人伸手按一下`
    3. `不知道还有几秒到 —— 这类假数据我们不显示`
  - 底部字幕：**`所以：位置在没装传感器之前是推测的 —— 推测我们就标出来。`**

> **口播稿**（约 20 秒）
> "这个项目最容易被问穿的一句话是：你怎么知道电梯在几楼。
> 我们的回答是：**现有硬件测不出来，我们不假装。**
> 真能做到的三件事：舵机真的物理按压；不用配对、靠蓝牙信号强度判层，40 到 200 毫秒；
> 全工程只有两个能发命令的入口，**没有任何定时器会自己按**。
> 做不到的三件事也先说：测不出轿厢真实位置、控制不了电梯、不知道还有几秒到。
> **位置在没装传感器之前是推测的 —— 推测，我们就标出来。**"

---

## 镜 7 · 结尾　2:22 – 2:32

- **画面**：两行大字 + 一行小字，2.8 秒后浮出一张卡片。
- **屏幕文字**：
  - `呼梯是真的`（绿色）
  - `位置测不到，就标出来`
  - 小字：`装置不碰电梯任何线路 · 10 秒可拆 · 全程离线 · 零预算`
  - 卡片：`本片无配音，字幕就是口播稿` / `真机画面请用《演示视频_分镜脚本》现场拍摄` / `备选素材：preview/storyboard.html（30 秒演出）`

> **口播稿**（约 10 秒）
> "装置不碰电梯任何线路，10 秒可拆，全程离线，零预算。
> **呼梯是真的；位置测不到，我们就标出来。**"

---

## 附：真机版视频的拍摄清单（演示当天 20 分钟搞定）

| # | 镜头 | 机位 / 器材 | 时长 | 备注 |
|---|---|---|---|---|
| 1 | 手机靠近呼梯面板，按钮自动浮出 | 手持 + 手机录屏（同时开） | 15 s | 一定要拍到"浮出"的瞬间 |
| 2 | 手指点一下 | 手机录屏 | 5 s | 录屏里能同时看到按钮按下和状态变化 |
| 3 | 舵机臂推出去、呼梯灯亮 | 手机横拍侧面，靠墙稳定 | 10 s | **这一镜是全场最有说服力的一镜** |
| 4 | 手机收到回执 `1F\|OK:UP` | 手持 | 5 s | 回执文字要清楚 |
| 5 | 抬头看井道透视叠在走廊上 | 手机横拍，慢慢抬起 | 15 s | 拍之前先站定 3 秒 |
| 6 | 轿厢动画下来、到站、开门 | 手机录屏 | 15 s | 主动念一句"这里的位置是模拟的" |
| 7 | 收尾一句 | 手机横拍 | 8 s | 台词见镜 7 口播稿 |

- 拍摄顺序建议：**先拍 3（最怕出问题，先拿下）→ 再拍 1/2/4（App 流程）→ 最后拍 5/6（井道）**。
- 剪辑：用手机自带剪辑即可，把上面的口播稿录成旁白贴上去，**总长压在 3 分钟内**。
- 如果当天装置出问题：**直接用这一版 `演示视频_备用.mp4`**，它已经独立成片，不需要任何硬件。

---

*本脚本对应视频版本：2026-10-18 生成的 `演示视频_备用.mp4`（152.0 s / 3800 帧 / 1280×720 / H.264）。*
*视频里的每一个数字都来自 `mech/cad/build.py` 与 `参数与校验报告.md`，改尺寸必须重新出片。*
