Mocen-Bear/Mocen_Elevator_Ctrl/packages/发给队友_透视井道/_版本信息.md

# 追加包 · 版本信息

- **包名：发给队友_透视井道**（独立追加包，**不属于**主资料包 `发给队友`）
- **版本：v1**
- **打包日期：2026-10-17**

## 这是什么

主资料包（`发给队友`，v1.0，那 3 份）解决的是**"靠近电梯 → 按钮浮出来 → 按下去"**。
这个追加包解决的是**另一个、可选的效果**：在 AR 里叠一座**半透明发光的 3D 电梯井**。

**主包不做这个效果就完全不用读这份。**

## 包含的文件（就这 1 份）

| 文件 | 内容 | 源文件最后修改 | SHA-256（前 16 位） |
|---|---|---|---|
| `SHAFT_MODEL.md` | 3D 半透明发光电梯井：尺寸表、逐件配色、全息材质配方、井道锚定方案、2D 叠加用的投影公式；并说明"轿厢位置是不是真数据" | 2026-10-17 01:16 | `545283EBABD98F75` |

## 有一个前提必须先接受

`SHAFT_MODEL.md` 第 0 节有一条**硬性要求**：

> 现有硬件（两块 ESP32 只会按按钮，电梯不给我们任何反馈）**测不出真实轿厢位置**。
> 所以井道里显示的轿厢位置，要么来自**额外传感器**（听电梯到站的"叮"声 / 看呼梯按钮的灯），
> 要么就是**推测**——**只要是推测，界面上就必须标注"模拟/推测"。**

这条不能省。有人问"你怎么知道电梯在 3F"时，没有标注是会被直接问穿的。

## 版本对不上怎么办

本包版本号是 **v1**。如果你拿到的是 v0 或没有版本封面，说明是旧拷贝。
（本包只含 `SHAFT_MODEL.md` 这一份；它被修改时会单独升版本号，**不会**连带改动主资料包。）
