Mocen-Bear/Mocen_Elevator_Ctrl/docs/项目资料/03_展示内容.md

# 03 · 展示内容

> 展示材料：**PPT / 演示视频 / 现场运行方案 / 备用演示材料**。
> 这一份是"怎么把东西讲给对方听"的说明书 —— 材料在哪儿、怎么放、出问题走哪条退路。

---

## 1. 展示 PPT

| 项 | 值 |
|---|---|
| 文件 | `presentation/电梯呼叫_项目展示.pptx` |
| 页数 | **14 页** |
| 尺寸 | 16:9（13.33 × 7.5 英寸），PPT 2010 及以上 / WPS / Keynote 均可打开 |
| 体积 | 约 663 KB（图片已内嵌，**离线可放**） |
| 字体 | 微软雅黑（Windows 自带）；若在 Mac 上放，请预留一次"替换字体"的时间 |
| 配色 | 深色底 `#080F1A` + 青色强调 `#2ECBFF`，和网页演示台、视频**同一套配色** |

### 14 页目录

| 页 | 内容 | 要点 |
|---|---|---|
| 1 | 封面 | 项目名 + 一句话简介 |
| 2 | 问题 | 电梯厅里的三件小事；我们的边界：只动"人伸手按按钮" |
| 3 | 怎么做 | 靠近 → 判层 → 浮出 → 按下（四步），并回答"为什么判层放手机里" |
| 4 | 硬件 | 不是模拟点击，是真的手 + 机构特写图 |
| 5 | 井道透视 | 看得见的规矩 + 一条不会越界的红线 + 总装背面图 |
| 6 | 能力边界 | 先说做不到的（4 条能做 / 4 条做不到） |
| 7 | 真位置 | "车在几楼"的两条路：听叮声、读楼层显示 |
| 8 | 实测数字 | 抖动对比表（25.7 → 4.3 → 1.3 次） |
| 9 | 实物样机 | 可 3D 打印的样机总装图 |
| 10 | 样机原理 | `行程 = R·sinθ` + 原理图 + 干涉检查结论 |
| 11 | 打印与装配 | 零件一览 / 打印摆放 / 爆炸图 + 装配要点 |
| 12 | 现场怎么演 | A 真机 / B 30 秒演出 / C 备用视频 |
| 13 | 技术栈 | 硬件固件 / 安卓 / iOS 三条线的分工 |
| 14 | 结尾 | 一句话总结 + 仓库地址 |

### 讲的时候注意

- **第 6 页（能力边界）不要跳。** 主动说"我们测不出轿厢位置"，比被有人问出来得分高。
- **第 8 页的数字可以当场复现**：打开 `preview/rssi_floor_sim.html`，现场拖参数。
- 网页互动版（可选）：`preview/deck.html` 是同内容的 11 页网页版，键盘 ← → 翻页、`F` 全屏。
  如果会场只有浏览器、没装 Office，**就用它顶上**。

---

## 2. 项目演示 / Demo 视频

| 项 | 值 |
|---|---|
| 主文件 | `media/demo/演示视频_备用.mp4` |
| 时长 | **152.0 秒（2 分 32 秒）** —— 满足"≤ 8 分钟" |
| 规格 | 1280 × 720，25 fps，H.264 / yuv420p，约 5.1 MB |
| 音轨 | **无配音**。字幕就是完整口播稿（见 `演示视频_分镜脚本.md`） |
| 分镜脚本 | `项目资料/演示视频_分镜脚本.md`（逐镜含口播稿 + 真机补拍清单） |

### 内容（7 镜）

1. 封面（8 s）
2. 问题（18 s）
3. **控制链**（38 s）—— 手机 → BLE → ESP32 → 舵机 → 按钮 → 到站开门，**整条链按真实时序走**
4. **机构特写**（16 s）—— 真实比例剖视，`行程 = R·sinθ` 实时读数
5. **可 3D 打印的实物样机**（42 s）—— 9 张 CAD 图逐张展示
6. **能力与边界**（20 s）—— 先说做不到的
7. 结尾（10 s）

### 诚实说明（必须保留）

- 视频里的**机构运动、舵机角度、行程数字全部是真值**（由 `mech/cad/build.py` 算出）。
- 视频里的**轿厢位置是模拟的**，片中没有把它说成实测 —— 这与我们在 App、网页上的做法一致。
- 视频**没有实拍真机画面**（演示前电梯厅进不去、装置只能现场贴）。这正是脚本里给出"真机补拍清单"的原因：
  演示当天用 20 分钟补拍 7 个镜头，剪成 3 分钟以内的真机版，**直接替换本片**即可。
- **本片可以独立放映**：不需要电梯、不需要硬件、不需要网络。

---

## 3. 现场运行方案

> 详细的、给自己人看的操作手册在 `演示材料/现场演示手册.md`。这里只列骨架。

### 3.1 硬件清单（一个双肩包）

| 物品 | 数量 | 说明 |
|---|---|---|
| ESP32 开发板 | 2 | 已烧 `elevator_1F.ino` / `elevator_2F.ino`（预编译镜像在 `releases/firmware/`） |
| MG90S 舵机 | 2 | 装在面板上；**VCC 必须接外部 5V，严禁接 3V3** |
| 外部 5V 电源 | 1 | 充电宝 + 5V 升压模块；**GND 必须与 ESP32 共地** |
| 安卓手机 | 2 | 装自行构建的 `app-debug.apk`（第二台作为备份） |
| 固定件 | 若干 | 美纹纸胶带 / 扎带 / 泡棉胶 —— 用来把舵机臂对准呼梯按钮 |
| 笔记本 | 1 | 开 `preview/` 里的网页演示台（离线可用） |
| 3D 打印样机（可选） | 1 套 | 打印件 + 装配说明书；能带来就在展台演示"按钮真的被按下去" |
| 接线与工具 | 1 套 | 杜邦线、备用 Micro-USB 线、小螺丝刀 |

### 3.2 场地要求

- **任意一部 ≥ 4 层的电梯**，我们只在 **2F 和 3F 的电梯厅**贴装置（这两层才有板子）。
- 贴装置的位置：呼梯按钮旁边，用胶带固定；**不挡人、不挡按钮、10 秒可拆**。
- 需要一点点手机信号/蓝牙环境 —— 我们**不需要 Wi-Fi、不需要互联网**。

### 3.3 到场后 10 分钟落地（四步）

1. **贴装置**：舵机臂对准呼梯按钮，手动试一次行程（松 → 按到底），确认按钮真的被压下。
2. **通电**：看板载 LED / 串口启动正常，手机蓝牙能看到 `ELEV-2F`、`ELEV-3F` 两个名字。
3. **点一次 UP**：确认三件事同时发生 —— 舵机动、呼梯灯亮、手机收到 `2F|OK:UP`。
4. **记一次信号**：站在 2F 门口和 3F 门口各看一次 App 上的 dBm，**两者差 ≥ 8 dB** 才稳；
   差得少就把装置往门口再贴一点。

### 3.4 3 分钟演示脚本

| 时间 | 动作 | 台词 |
|---|---|---|
| 0:00 | 站在 2F 电梯厅，掏出手机 | "我们现在在电梯厅。**我们不碰任何公共按钮。**" |
| 0:15 | App 上"2F 上行"按钮自动浮现 | "手机靠蓝牙信号强度就知道我在 2F、离井道多近 —— **按钮自己浮出来**。" |
| 0:25 | 点一下按钮 | "点一下就行。" |
| 0:30 | 指墙上：舵机动、灯亮 | "**看，舵机真的把电梯的按钮按下去了**，呼梯灯亮。" |
| 0:40 | 手机收到回执 | "回执 `2F\|OK:UP` —— 这表示**我的动作完成了**。" |
| 0:50 | 打开井道透视 | "抬头看：**井道就是叠在走廊上的**。" |
| 1:00 | 轿厢动画下来 → 到站 | "轿厢从 4F 下来，到 2F。"（**如果是模拟，主动说"这里的位置是模拟的"**） |
| 1:20 | 再点一次 ▲/▼ 呼一次 | "呼梯永远是「**你所在那一层**」的按钮；去哪层只用来决定上/下。" |
| 1:40 | 收尾 | "**呼梯是真的；位置我们没装传感器前不假装。**" |

> **主动说"模拟"是加分，不是减分。** 一句话就补上：
> "位置我们现在是模拟的，但两条真实位置的路已经写好代码了 —— 一个听电梯到站的叮声，一个用摄像头读电梯自己的楼层显示（实测单帧 84~89% 读对）。"

### 3.5 出问题怎么办（照表走，别现场发呆）

| 症状 | 先查 | 还不行 |
|---|---|---|
| 舵机不动 | 舵机 5V 有没有？GND 共地没有？D12 烧录时拔了有没有插回？ | 手动按一下按钮，只演示"手机浮出按钮 + 井道透视" |
| 手机扫不到 `ELEV-*` | 板子还在广播吗（串口打印）？关开一次手机蓝牙；重启板子 | 换第二台手机；或用笔记本 Chrome 开 `preview/ble_console.html` 直接点 UP/DOWN |
| 楼层数字乱跳 | 站远/站近 30 cm 再看 | 用 `preview/rssi_floor_sim.html` 现场选参数（滞后提到 4~5 dB、连赢 2 次） |
| 电梯半天不来 | 别干等 | 改演"按下 → 灯亮 → 回执"，轿厢说"用模拟演示行进" |
| App 崩了 / 手机没电 | — | 开 `preview/elevator_3d_preview.html` 或 `elevator_ui_preview.html` 顶上 |
| **什么都跑不起来** | — | ⭐ 开 `preview/storyboard.html` 点「放映模式」（或按 `F`）：30 秒把全流程演完，**不用任何硬件** |

### 3.6 演示前 60 秒"最后一分钟"检查

```
[ ] 板子通电、串口有打印、手机看得到 ELEV-2F 和 ELEV-3F
[ ] 点一次 UP：舵机真的动、灯真的亮（这一步一定要在下楼之前做！）
[ ] 手机亮度拉满（呼梯按钮要看得到）
[ ] preview/storyboard.html 已经在浏览器里开着（保险）
[ ] preview/elevator_3d_preview.html 已经开着（别现场找文件）
[ ] 成片 `演示视频_备用.mp4` 已经拷到桌面（终极保险）
```

---

## 4. 备用演示材料（会场没有硬件 / 没有网络也能讲完）

所有备用材料都在 `preview/` 目录里，**双击就能开，全部离线**，入场前把整个 `preview/` 拷到桌面。

| 优先级 | 文件 | 是什么 | 什么时候用 |
|---|---|---|---|
| ★★★ | `media/demo/演示视频_备用.mp4` | 2 分 32 秒成片 | 最后一道保险，独立成片 |
| ★★★ | `preview/storyboard.html` | **30 秒产品演出**，一页演完全流程（走近→浮出→点按→舵机按→灯亮→井道→轿厢→到站→开门） | 真机在会场出问题 |
| ★★★ | `preview/deck.html` | 11 页网页版幻灯片，键 `← →` 翻页、`F` 全屏 | 会场没有 Office |
| ★★★ | `preview/elevator_3d_model.html` | **交互式 3D 控制链演示**：井道 + 呼梯面板 + 6 环节控制链按顺序点亮 + 真实尺寸机构剖视 + 回执日志 + 判层仿真，可拖拽旋转、可录屏 | 讲"整条链怎么走的"这一页；也可当 30 秒演出的升级版 |
| ★★☆ | `preview/elevator_3d_preview.html` | 井道 3D 透视（可拖拽旋转） | 讲"井道透视"这一页 |
| ★★☆ | `preview/rssi_floor_sim.html` | 判层算法调参器 + 抖动仿真 | 对方质疑"会不会乱跳" |
| ★☆☆ | `preview/floor_display_reader.html` | 七段楼层显示识别器（可传现场照片当场自测准确率） | 讲"真实位置的两条路" |
| ★☆☆ | `preview/chime_calib.html` | 到站"叮"声标定台 | 讲"听叮声"那条路 |
| ★☆☆ | `preview/ble_console.html` | 网页版蓝牙控制台，选中 `ELEV-2F` 直接点 UP | 手机 App 扫不到装置时救场 |
| ★☆☆ | `preview/elevator_ui_preview.html` | 手机界面静态预览 | App 崩了的时候顶上 |
| ★☆☆ | `预览/01…09_*.png` | 9 张 CAD 图原图 | 想放大看零件细节 |
| ★☆☆ | `presentation/电梯呼叫_项目展示.pptx` | 14 页 PPT | 有线投影但没网 |

> **网页里唯一需要网络的地方**：`elevator_3d_model.html` 里的"数据来源"标记支持 `?api=` 轮询，但**没有后台时会自动降级为"模拟"**，不报错。
> 其余所有页面**完全不联网**。

---

## 5. 彩排建议

1. **完整走一遍 3 分钟脚本**（含"如果电梯不来"的分支），至少两遍。
2. **故意拔掉舵机电源**再走一遍 —— 练的就是"舵机不动"这条退路。
3. **提前把第 6 页（能力边界）背熟**，尤其是被追问"你怎么知道电梯在几楼"的标准答法。
4. **提前把第 8 页的三个数字背熟**：25.7 次 → 4.3 次 → 1.3 次；真机判定 40~200 ms。

---

*本文件属 `项目资料` 包（2026-10-18）。文中所有文件路径均相对仓库根目录。*
