Mocen-Bear/Mocen_Elevator_Ctrl/docs/演示材料/能力与边界.md

# 能力与边界（常见问答用 · 一页纸）

> 用法：**答之前先认边界**。这个项目最容易被打穿的一句话是"你怎么知道电梯在几楼"。
> 把下面这张表背下来，被问到时**先承认测不到，再说我们有两条真路**，可信度反而最高。

---

## A. 我们**真能**做到的（每条都写了证据在哪）

| # | 能力 | 到什么程度 | 证据 / 在哪 |
|---|---|---|---|
| 1 | **不用配对、不用掏卡的呼梯** | 手机靠 BLE 广播的 RSSI 就判断"你在哪一层、离井道多近"，**不建立连接**；判定 **40~200 ms**（扫到新广播立刻重判、节流 40 ms；200 ms 心跳兜底），感觉是瞬时的 | 安卓三处：`ElevatorDevice.kt`（`RSSI_WINDOW=3 / EMA_ALPHA=0.62`）、`FloorJudge.kt`（`minLeadDb=3 / winCount=1 / minRssi=-95`）、`BleManager.kt`（`EVAL_THROTTLE_MS=40 / TICK_MS=200`）；协议见 `BLE_PROTOCOL.md` |
| 2 | **真的把电梯按钮按下去** | 舵机物理按压，行程 350 ms + 保持 600 ms + 收回 350 ms；**不是模拟点击，是真手**。全工程只有 **2 个能真正发命令的入口**（▲/▼ 按钮、HTTP 接口），**没有任何定时器会自动呼梯**（v2：App 里那个语音入口已在 v10 删掉 —— 手机自带识别现场不可靠） | `firmware/elevator_2F/`（上行 **D13**、下行 **D12**），两块板只有 `FLOOR_NAME` 不同；`MainActivity.kt` 的 `sendCommand → tryCall` |
| 3 | **回执是真的** | 收到 `1F\|OK:UP` 表示"**舵机动作完成**" | `BLE_PROTOCOL.md`；固件里 `publishStatus()` |
| 4 | **多台手机同时用** | 一块 ESP32 最多 **3 台**手机；回执用 notify **广播**给所有已订阅的手机（一台断开不影响别人） | 固件 v5（把单个 `gConnected` 改成广播） |
| 5 | **看得见的 3D 井道** | 手指拖动旋转（**不自动转**）；**只有 1F/2F 画全**，B/3F 半透明虚影；轿厢随最近楼层靠近，**永不自动呼梯** —— 信号/判定回调（`refreshUi()`）里**一行"发命令"的代码都没有**，只有 `moveCarTo()`（纯视觉）；**B/3F 根本没有装置，手动选了也会被拒绝**（`tryCall()` 第一句就是 `if (!deviceFloors.contains(f)) return "$f 没有呼梯装置"`） | `android/.../ElevatorView.kt` 常量 **81–101 行**（几何）；`MainActivity.kt` 的 `refreshUi()` / `tryCall()`；预览 `preview/elevator_3d_preview.html` |
| 6 | **AR 透视井道（可照抄的规格）** | 尺寸、逐件配色、全息材质配方、井道锚定的 3 种方案、2D 投影公式；**和安卓端完全一致** | `SHAFT_MODEL.md`（v1，独立追加包） |
| 7 | **摄像头读出电梯自己的楼层显示**（真位置） | 纯几何七段识别，**单帧 84~89% 读对、0~2% 读错**，其余输出"未识别"；实时要求**连续 3 帧一致** | `preview/floor_display_reader.html`（三种模式，可现场自测） |
| 8 | **听"叮"声判断到站**（真位置） | 4 kHz 采样 + RMS/过零率判"叮"，报 `1F\|CAR:CHIME`；**固件已写好并编译通过，但未上机标定** | `firmware/chime_node/chime_node.ino`；`CAR_POSITION.md` §2。标定用 `preview/chime_calib.html`（跑同一套 DSP，直接给可粘回固件的宏）；离线自测里**已经抓出并修掉一个"频率被算小一半"的真 bug** |
| 9 | **没有硬件也能演完** | 一页 30 秒演出：走近→按钮浮出→点按→舵机按下→灯亮→井道→轿厢→到站→门开→再按一次「下行」；可全屏/录屏 | `preview/storyboard.html`（按 **F** 进放映模式） |
| 10 | **"瞬时"和"不抖"是可以当场证明的** | 把 App 的判定算法（中位窗口 3 · EMA 0.62 · 滞后 3 dB · 连赢 1）逐行搬到网页，配室内传播模型 + 噪声做仿真：站在某层装置旁 20 s **0 次抖动**，首判 = **1 个采样周期（200 ms）**；站在两层**正中间**（最坏位置）朴素做法 20 s 横跳 **25.7 次**，我们的算法 **4.3 次**；换推荐现场参数（4.5 dB / 连赢 2）只剩 **1.3 次**（降 **19×**），换层延迟只多 0.3 s。**注意口径**：仿真故意按最保守的 200 ms 采样；真机里 `BleManager.kt` 每扫到一次新广播就立刻重判（节流 **40 ms**），另有 200 ms 心跳兜底 —— 所以真机只会更快（**40~200 ms**，两个数都对，别被问住） | `preview/rssi_floor_sim.html`（可现场调参，也可拖动"我"的位置看判定） |

---

## B. 我们**明确做不到**的（**必须先说**）

| # | 做不到 | 为什么 | 我们怎么处理 |
|---|---|---|---|
| 1 | **测不出轿厢真实位置** | 两块 ESP32 只会"按按钮"；电梯控制系统不给我们任何反馈。`OK:UP` = "我按了"，**不是** "车动了" | **UI 上永远标来源**：真数据（听叮/摄像头）或"模拟"。`SHAFT_MODEL.md` §0 把这条写成硬性要求 |
| 2 | **控制不了电梯** | 没有授权，也没有电梯系统的接口 | 我们做的是"**厅外呼梯**" —— 等价于一个人伸手按按钮。不改电梯任何电气连接，装置 10 秒可拆 |
| 3 | **不知道行进方向 / 还有几秒到** | 同上，没有反馈通道 | 不显示"还有 5 秒"这类假数据；最多按经验给一个"约 1 层/2 秒"的模拟曲线并标注 |
| 4 | **AR 里没有遮挡** | ARKit 默认没有遮挡能力（人/墙不会挡住井道） | 主动选"半透明发光线框"**透视光绘**风格 —— 不是做不到遮挡的妥协，是刻意的设计语言 |
| 5 | **跨楼层的位姿定位没有** | 队友那套 LiDAR/ARKit 是 **4-DoF 单楼层地图**，跨层解算尚未实现（见其 §4） | 所以**楼层判断**这一环由我们自己的 BLE 承担，不依赖队友那套 |

---

## C. 三个最可能被追问的点 · 逐字答法

**Q1「你怎么知道电梯在 2F？」**
> "**现有硬件测不出来，我们不假装。** 井道里那个轿厢，来源只有两种：真的，或者模拟的。
> 真的我们写了两条路：一是挂在井道边听电梯到站的叮声（固件已经写好、编译通过，现场要标定一次）；
> 二是用摄像头读电梯自己那块楼层显示（纯几何七段识别，实测单帧 84~89% 读对、读错 0~2%，
> 剩下全部输出'未识别'，实时还要求连续 3 帧一致）。
> 两条都没装的时候，界面上会打一个'模拟'角标。"

**Q2「这不是很危险 / 违法的吗？」**
> "没有。我们**只按公共呼叫按钮**，不改电梯任何线路，也不碰电梯控制柜。
> 相当于把'有人伸手按一下'自动化了。演示用的装置是**贴上/取下**的，不改建筑。"

**Q3「单帧会读错，那还有什么用？」**
> "我们**宁可说'没看清'也不猜**：识别器有明确的"不确定就拒识"逻辑，
> 而且实时模式要求**连续 3 帧一致**才采纳。所以它输出的数字可信度远高于单帧准确率本身。"

---

## D. 一句话总结（收尾用）

> **呼梯是真的（舵机真按）；位置在没装传感器之前是推测的 —— 推测我们就标出来。**
> 而且我们已经把两条"变真"的路写好了，随时可以装上去。

---

## E. 版本

- 本页 2026-10-18 修订，属 **`演示材料` v2**。
- v2 改了什么：**口语呼梯（语音）整条入口删掉了** —— 真机上手机自带识别不可靠，
  App v10 已经把语音按钮、`VoiceController.kt`/`VoiceParse.kt`、麦克风权限全部删除。
  所以上表第 2 条从"3 个人工入口"改成"**2 个**"（▲/▼ 按钮、HTTP 接口）；第 9 条演出节拍里的"语音"改成"**门开 → 再按一次下行**"。
- 引用的文件：`BLE_PROTOCOL.md`、`firmware/`、`SHAFT_MODEL.md`、`CAR_POSITION.md`、
  `preview/floor_display_reader.html`、`preview/storyboard.html`、`android/.../ElevatorView.kt`。
