Mocen-Bear/Mocen_Elevator_Ctrl/docs/android/_版本信息.md

# 安卓 App 包 · 版本信息

- **包名：`安卓App`**（独立新包，**不属于**已有的任何包）
- **版本：v12**（v1 ~ v11 的包都已删除，别再用旧的）
- **打包日期：2026-10-18**
- 内容：安卓 App 安装包 —— v1 的「队友导航 App 效果模拟页」 + v2 的「摄像头读楼层」 +
  v3 的「两台电梯 + 全屏电梯页」 + v4 的「两个层显一样大」 + v5 的「摄像头页读数看得清 + 屏幕不自动关」 +
  v6 的「轿厢楼层兜底来源改名 `蓝牙判层`」 + v7 的「甲梯跟着你走 + 到站开门 + 乙梯随机跑」 +
  v8 的「开门后不再是一块黄板 —— 真的能看到轿厢里面」 +
  v9 的「主界面也变成两台电梯 + 层显下面不再有小字」 +
  v10 的「把语音整个删掉（按钮 / 代码 / 麦克风权限）」 +
  v11 的「楼层号 2F/3F → 1F/2F」 +
  **v12 的「井道四层改成 B / 1F / 2F / 3F」**

## 这一版改了什么（v11 → v12）

**起因**：一句话 —— 「**把App改成B，1，2,3这四层，其余不变**」。
井道四层从 `1F / 2F / 3F / 4F` 改成 **`B / 1F / 2F / 3F`**（最底下多出 B、顶上拿掉原来的 4F）；
**装置没挪，还是 1F / 2F**（`ELEV-1F` / `ELEV-2F` 两个广播名、能呼 / 能判层的楼层都没变）。

| 改动 | 说明 | 文件 |
|---|---|---|
| **① 井道四层换号** | 四处楼层表 `listOf("1F", "2F", "3F", "4F")` → **`listOf("B", "1F", "2F", "3F")`**：主界面井道、全屏电梯页井道、队友 App 效果页井道、摄像头页楼层白名单 | `MainActivity.kt`、`NavMockActivity.kt`、`ElevatorView.kt`、`CameraFloorActivity.kt` |
| **② 「队友 App 效果」页跟着换** | 三排井道胶囊（各 4 粒、按位置绑字）整体前移成 **`B / 1F / 2F / 3F`**；默认示例停靠从 4F 改成 **3F**；"你在哪"两粒胶囊**仍是 1F / 2F**（有装置的才有） | `activity_nav_mock.xml`、`NavMockActivity.kt` |
| **③ 灰掉的楼层换人** | 没装置的楼层从「3F / 4F」变成「**B / 3F**」：主界面灰按钮、井道里的半截虚影、"本演示只有 1F / 2F 能呼叫 / 能判层"的文案、摄像头页（白名单 + 手动指定提示）全部同步 | 5 个 `.kt` + `activity_main.xml` |
| **④ 注释 / 口径跟着换** | 源码注释里的 `1F~4F` 全部改成 `B~3F`（含乙梯随机跑的口径） | 同上 |
| **⑤ APK 干净重编** | 同一套环境 `gradle clean assembleDebug` **全量干净重编**（不用增量，避免打包空洞）；BLE 协议、扫描前缀 `ELEV-`、白名单机制一个字没改 | 本包 `电梯呼叫_v12.apk` |

**没改的东西**：BLE 协议、扫描/连接、呼梯逻辑与白名单机制、楼层键、甲乙两台电梯的画法与分工、
`CarFloorSource`、`/api/status` 的字段名与取值（`car2` 还是 `null`）、门开合（停 **1.8 秒**）、乙梯随机跑。

> **底线没破**：呼梯入口还是 **2 个**（▲/▼ 的点击 + HTTP 接口），都经过 `tryCall()` 白名单校验、**都没有自动呼**；
> 乙梯"随机跑"**依然只在界面里演**，**不写进 `CarFloorSource`**（`/api/status` 里 `car2` 还是 `null`）。
> 装置所在的 **1F / 2F 没动** —— 所以"能呼、能判层"的还是这两层；**B / 3F 没有装置，点它们呼叫照样被 `tryCall()` 拒绝**。

## 这一版改了什么（v10 → v11）

**起因**：一句话 —— 「**将2,3层改为1,2层，只改我自己的程序和App**」。
呼梯装置从 2F/3F 挪到 **1F / 2F**（固件和 App 两侧同步改），所以 App 里"**哪几层有装置、能呼、能判层**"全部从 2F/3F 换成 1F/2F。

| 改动 | 说明 | 文件 |
|---|---|---|
| **① 能呼 / 能判层的楼层换号** | `deviceFloors`（只有装了装置的楼层能呼叫）从 `"2F", "3F"` → `"1F", "2F"`；底部"等靠近 X"、灰按钮、"没有呼梯装置"提示全部同步 | `MainActivity.kt`、`NavMockActivity.kt` |
| **② 「队友 App 效果」页的模拟开关换号** | "你在哪"两粒胶囊 2F/3F → **1F/2F**（布局 `pillYou2/pillYou3` 改名 `pillYou1/pillYou2` 并改字）；默认示例"你在 2F" → "你在 **1F**"（`youFloor`/`carA`/`callFloor`），甲梯跟着你在 1F | `activity_nav_mock.xml`、`NavMockActivity.kt` |
| **③ 界面文案 / 注释换号** | 主界面副标题 `…点 2F/3F + ▲▼ 呼梯` → `…点 1F/2F + ▲▼ 呼梯`；"本演示只有…"、寻找装置提示与各类注释同步；井道仍是 1F~4F 全 4 层，**3F/4F 灰掉** | 共 9 个文件 |
| **④ APK 重新编译** | 和 v10 同一套环境 `gradle assembleDebug` 重编；两个新广播名 `ELEV-1F` / `ELEV-2F` 直接被扫描前缀 `ELEV-` 兼容，**BLE 协议一个字没改** | 本包 `电梯呼叫_v11.apk` |

**没改的东西**：BLE 协议、扫描/连接、呼梯逻辑与白名单机制、楼层键、甲乙两台电梯的画法与分工、
`CarFloorSource`、`/api/status` 的字段名与取值（`car2` 还是 `null`）、摄像头页、
门开合（停 **1.8 秒**）、乙梯随机跑。

> **底线没破**：呼梯入口还是 **2 个**（▲/▼ 的点击 + HTTP 接口），都经过 `tryCall()` 白名单校验、**都没有自动呼**；
> 乙梯"随机跑"**依然只在界面里演**，**不写进 `CarFloorSource`**（`/api/status` 里 `car2` 还是 `null`）。

## 这一版改了什么（v9 → v10）

**起因**：一句话 —— 「**识别不了语音，直接把语音功能删掉吧**」。
真机上手机自带的识别对"去三楼 / 上行"这种短句不靠谱，那就不留一个**按了没反应**的按钮。

| 改动 | 说明 | 文件 |
|---|---|---|
| **① 语音按钮删掉** | 主界面（老界面）那个 `语音呼叫` 按钮、以及「队友 App 效果」页大屏里的 `🎤 语音呼叫` 按钮**整块从布局里删掉** | `activity_main.xml`、`activity_nav_mock.xml` |
| **② 语音代码删掉** | `VoiceController.kt`（持续聆听 + 错误分级退避）和 `VoiceParse.kt`（口语 → 楼层+方向）**两个文件直接删除**；两个 Activity 里的语音字段 / 权限回调 / `toggleVoice` / `onVoiceText` / `onPause`、`onDestroy` 里的收尾全部拿掉 | `MainActivity.kt`、`NavMockActivity.kt`（+ 删 2 个 .kt） |
| **③ 麦克风权限不再申请** | `AndroidManifest.xml` 里的 `RECORD_AUDIO` 权限**删掉** —— 装 v10 之后**不会再问麦克风权限**（蓝牙、摄像头权限照旧） | `AndroidManifest.xml` |
| **④ 文案 / 图标跟着改** | 主界面副标题从 `…点 2F/3F 或 ▲▼ 说话呼梯` 改成 `…点 2F/3F + ▲▼ 呼梯`；`voice_off` / `voice_on` / `mock_big_voice` 三个字符串和只给语音按钮用的 `ic_mic` 图标一起删掉 | `strings.xml`、`res/drawable/ic_mic.xml` |
| **⑤ 语音这条"入口"从说明里去掉** | 代码注释里的"呼叫入口"从 **3 个**（▲/▼、语音、HTTP 接口）改成 **2 个**（▲/▼、HTTP 接口），底下说明文档同步 | `MainActivity.kt`、`NavMockActivity.kt`、本包 `安装说明.md` |
| **（网页版同步）** | `preview/teammate_app_mock.html`（队友 App 效果页网页版，含 Web Speech 那段）、`preview/elevator_ui_preview.html`（界面预览里的 `🎙 语音呼叫`）**都删掉了语音按钮和它的代码** | preview 两个页面 |

**没改的东西**：BLE 协议、扫描/连接、呼梯逻辑与白名单 `tryCall()`、楼层键、甲乙两台电梯的画法与分工、
`CarFloorSource`、`/api/status` 的字段名与取值（`car2` 还是 `null`）、摄像头页、
门开合（停 **1.8 秒**）、乙梯随机跑（3~4.6 秒一次）。

> **底线没破**：呼梯入口现在只剩 **2 个**，而且**都是人主动点的** ——
> `sendCommand(` 的调用点只有 ▲/▼ 的点击 和 HTTP 接口两处；`refreshUi()` / `onNodesChanged()` 里**依然一行呼梯代码都没有**；
> 乙梯那个"随机跑"**依然只在界面里演**，**不写进 `CarFloorSource`**（`/api/status` 里 `car2` 还是 `null`）。

## v9 带来了什么（v12 沿用，别忘）

**起因**：两句话 —— ①「**我的安卓端软件也整成两台电梯**」；②「**显示楼层那里不要出现下面的小字**」
（指层显框里那个大数字**下面**那行小字，例如 `模拟 · 跟着你（蓝牙判层）` / `模拟 · 另一台电梯`）。

| 改动 | 说明 | 文件 |
|---|---|---|
| **① 主界面也是两台电梯** | 进 App 第一页（老界面）从"一台井道"改成**甲梯 / 乙梯两台并排**，井道上各挂一个 `甲梯` / `乙梯` 小胶囊，样式和全屏大屏一致 | `activity_main.xml` |
| **② 层显只放一个大数字** | 两台电梯上面各一个层显框，**甲 / 乙 一样大、左右各占一半（正好在各自井道正上方）**；框里**只有数字**，下面**不再写任何小字** | `activity_main.xml`、`activity_nav_mock.xml` |
| **③ 那两行小字删掉** | 全屏大屏两台层显下面的 `模拟 · 跟着你（蓝牙判层）` / `模拟 · 另一台电梯` **不再显示**（`bigStatusA/B` 两个控件连同赋值的代码一起删了）。两台车怎么分工，改由页面上方那行 `甲梯跟着你走，乙梯随便跑 · 有真读数就是真实值` 说明 | `activity_nav_mock.xml`、`NavMockActivity.kt` |
| **④ 主界面乙梯也随机跑** | 主界面的乙梯跟大屏一样：**1F~4F 随机换层（一次跳 1~2 层，每 3 秒多一次）**，纯画面装饰；甲梯还是跟着你（真读数 > 蓝牙判层） | `MainActivity.kt` |
| **⑤ 连接状态挪到底部那条** | 层显框里的"正在检测楼层… / 找到 N 台装置 / 在线 2/2"那行没了，改成写在**页面最下面那条状态栏**里（`外部接口 … · 正在检测楼层…` / `… · 找到 1 台装置 · 等靠近 2F / 3F`），呼叫目标那条也还在那儿 | `MainActivity.kt` |
| **（网页版同步）** | `preview/teammate_app_mock.html`：删掉那两行小字、两个层显改成左右各占一半（360px 的机身里各 **175px**，正好压在各自井道上 —— 逐块量过）；`preview/elevator_ui_preview.html`：层显下面那行 `在线 2/2` 一起去掉 | preview 两个页面 |

**没改的东西**：BLE 协议、扫描/连接、呼梯逻辑与白名单 `tryCall()`、摄像头页、
门开合（停 **1.8 秒**）、`CarFloorSource`（乙梯随机跑**依然只在界面里**，`/api/status` 的 `car2` 还是 `null`）、
`/api/status` 的字段名与取值、主界面底部 ▲/▼/楼层键的位置。

## v8 带来了什么（v12 沿用，别忘）

**起因**：v7 的开门效果**看得到门在开，但门缝里是"一块发光的黄板"** ——
看着像门后面又挡了一层，不像"门开了、能看见轿厢里面"。这一版把那块黄板拿掉：

| 改动 | 说明 | 文件 |
|---|---|---|
| **① 门缝里不再是黄板** | 以前两扇门滑开时，中间那道缝被**一整块亮黄色**填满（`#FFE7AE`）。现在**什么都不填** —— 直接透视到**轿厢内部**：后壁、地板、两侧内壁都在，门开多大就露多大 | `ElevatorView.kt` |
| **② 门一开，轿内自己"亮起来"** | 轿底 / 两侧内壁 / 后壁的颜色随开门进度**从暗色渐变到亮钢色**（不是突然切换）—— 门一开，里面是有纵深的亮轿厢 | `ElevatorView.kt` |
| **③ 轿内看得见的细节** | 后壁上一道**扶手线**；后壁上方一条**暖色顶灯光带**（黄光只有这么一小条，是"灯"，不是一整块板） | `ElevatorView.kt` |
| **④ 关门时中缝仍旧是那一线暖光** | 门关着时，中缝里那条细暖光**保持不变**（2px）；只有门开始打开，这层才消失、露出轿内 | `ElevatorView.kt` |
| **（网页版同步）** | `preview/teammate_app_mock.html`、`preview/elevator_3d_preview.html`、`preview/elevator_ui_preview.html` 三个页面用**同一套数学**同步改了；改动前后都用像素量过 | preview 三个页面 |

**没改的东西**：BLE 协议、扫描/连接、呼梯逻辑、甲跟乙的分工、
`CarFloorSource`（乙梯的随机跑**依然只在界面里**，`/api/status` 的 `car2` 还是 `null`）、
门开合时长（还是停 **1.8 秒**）、到站自动开门（`autoDoorOnArrive`）。

## v7 带来了什么（v12 沿用，别忘）

**起因**：演示时**只模拟一台电梯（甲梯）**。甲梯要"像真的"——你走到哪层它就在哪层、到了会开门；
另一台（乙梯）**不管它**，让它自己随便跑，画面不空就行。（当时还顺手加过语音按钮，**v10 已整个删除**。）

| 改动 | 说明 | 文件 |
|---|---|---|
| **① 到站开门效果** | 轿厢**到站停下时，门自动往两边滑开**（中间露出轿内 —— v8 起改成**真正的轿内**，不再是亮黄板），停约 **1.8 秒**再自己关上；**一走就关门**。井道里那台轿厢现在会"开门"，不再是死板的一块铁 | `ElevatorView.kt` |
| **② 甲梯 = 跟着你走** | 「队友 App 效果」页里，甲梯轿厢**跟着"你在哪层"走**（真机上就是蓝牙判层的结果）；点了悬浮钮呼梯，它还是**一层一层开过来**，到了**自动开门** | `NavMockActivity.kt` |
| **③ 乙梯 = 纯装饰，随机跑** | 乙梯不再"反着折返"，改成 **1F~4F 随机换层（一次跳 1~2 层）**，**每 3 秒多**换一次（间隔还带随机，看着不机械）。它**不代表任何真实读数**，页面上直接标 **`模拟 · 另一台电梯`**（v9 起这行小字已按你的要求删掉，改挂 `乙梯` 小胶囊） | `NavMockActivity.kt` |
| **④ 语音呼叫（v10 已删除）** | v7 时把大屏里的 **🎤 语音呼叫** 做成真能听（`VoiceController.kt` + `VoiceParse.kt`）。**v10 因为真机上识别不准，按钮、两个文件、麦克风权限全删了** | ~~`NavMockActivity.kt` + `VoiceParse.kt`~~ |
| **⑤ 界面上的字跟着改** | 顶部那行小字：`甲梯跟着你（2F）· 乙梯自动跑`；两台井道下面原本写 `模拟 · 跟着你（蓝牙判层）` / `模拟 · 另一台电梯`（**v9 起删掉**）；底部开关的「自动」挪到**乙梯那一行**（它现在只管乙梯） | `strings.xml` |
| **（网页版同步）** | `preview/teammate_app_mock.html`（队友 App 效果页的网页版）、`preview/elevator_3d_preview.html`、`preview/elevator_ui_preview.html` 都同步加了**开门效果**（甲跟乙随机也同步了） | preview 三个页面 |

**没改的东西**：BLE 协议、扫描/连接、呼梯（▲/▼）的白名单校验 `tryCall()`、计时器自动刷新（5 秒）、
**自动呼梯（本来就没有）**、`/api/status` 的字段名与取值（`carSource` 还是 `camera` / `manual` / `near`）、
摄像头页、以及"**甲/乙 = 左/右**"的判定规则，全部与 v6 一致。

## v6 带来了什么（v12 沿用，别忘）

| 改动 | 说明 | 文件 |
|---|---|---|
| **层显下面那行小字改口径** | 没有真读数时，写 **`蓝牙判层`**（不是"随便模拟一个数"，是**判出来的**：手机坐在轿厢里的人，靠近哪层的板就显示哪层） | `CarFloorSource.kt` |

## v5 / v4 / v3 带来了什么（v12 沿用，别忘）

| 改动 | 说明 |
|---|---|
| **v5：摄像头页读数看得清** | 楼层数字 40sp 挤左上角 → **72sp 居中**，乙梯 22sp → **44sp**；状态行 12sp → **14sp**、读到就变**亮绿**；**这一页开着时屏幕不自动关** |
| **v4：全屏电梯页最上面两个层显一样大** | 两台停同一层时不会出现两个不一样大的 `1F`（现在都是 56sp；v9 起两个层显**各占屏幕一半宽**，正好压在各自井道正上方，任何屏宽都不会溢出） |
| **v3：两台电梯（甲梯 / 乙梯）** | 厅里那块横屏**左边一位 = 甲、右边一位 = 乙**；摄像头**一次把两位都读出来**；全屏电梯页（两台 3D 井道 + 甲乙层显 + 楼层键 + ▲/▼ + 底部状态）；`/api/status` 多一个 `car2` |

### 为什么"甲/乙"是这么分的

算法读那块屏时，本来就是**从左到右**把每个数字位找出来的（按列空隙切开）。
所以"最左边那位 = 左边那台电梯"，也就是甲梯 —— 不需要额外配置。
只读到一位（只有一台电梯，或另一台没框进画面）也照样能用，另一位留空。
（蓝牙判层只给**甲梯**用 —— 我们呼梯装置装的就是那一台。）

### 「轿厢楼层」的来源（v9 口径，v12 未变）

硬件上我们**看不到轿厢**（没装传感器）。甲梯那个数字只有两种来路：

| 情况 | 层显上那个数字 | 哪儿写着它的来路 |
|---|---|---|
| 摄像头刚读到 / 现场手动指定过（**这条路现已搁置**） | 用真实的那一层 | 「队友 App 效果」页顶部那张卡（`真 · 摄像头 · 刚刚`）+ `/api/status` 的 `carSource` |
| 没有真读数（现在的默认情况） | **用"你靠近哪层"判出来的那一层** | 同上（写 `蓝牙判层`，接口里 `carSource = "near"`） |

> **v9 起：层显框里只有那个大数字，下面不再写小字**（你要的"干净"）。
> 这个数是**真读数还是蓝牙判层**，现在只在**队友 App 效果页顶部那张卡**和**给别的 App 的接口**里说清楚 ——
> 反正两条来路都是**有依据的**（真读数 or 你人在哪层），不是编出来的数。

> **蓝牙判层** = 手机坐在轿厢里的人，靠近 1F / 2F 的哪块板，就显示哪层。
> 装置只装在 **1F / 2F**，所以**只有这两层判得出来**；B / 3F 没装置，那两层判不出来。
> 读数超过 3 分钟没人更新（只对摄像头读数）会自动退回**蓝牙判层**。

> **乙梯是纯装饰**：它那个数字是**界面自己随机跑的**（B~3F，每 3 秒多换一次），
> **不代表任何真实读数**，也**不会写进 `CarFloorSource`**（`/api/status` 的 `car2` 因此还是 `null`）。
> 它上面挂着 `乙梯` 小胶囊、页面上方那行也写着"乙梯随便跑"。

> ⚠️ 摄像头那条路（"一台手机当监控"）现在**搁置**了，连同它的局限（一台手机既当监控又没法自己看显示）
> 相关取舍记录见 `docs/REPORT.md` 的「关键设计决策与取舍」一节。

## 包含的文件（就这 2 个）

| 文件 | 说明 | 大小 | SHA-256（前 16 位） |
|---|---|---|---|
| `安装说明.md` | 怎么装、怎么看效果、我没验过什么 | — | — |
| `_版本信息.md` | 本文件 | — | — |

> （v11 是 6044651 B / `01DC4C0DB779A2DA`。v12 比它**小了 106392 字节** —— 不是删了东西：v11 是**增量打包**、包里带着约 10 万字节的"打包空洞"（zipflinger 填充，不存任何内容）；v12 是**干净全量重编**，没有空洞。去掉空洞后的 v12（5938259 B）和 v10（5938279 B）几乎一样大，真正的改动内容其实只有几个字节。）

## 这一版是怎么验的（没有真机条件下能做到的极限）

- ✅ **v12**：`gradle clean assembleDebug` **干净全量重编通过**（38 个任务、25 秒，无报错，只剩原有的过时写法警告）。
  拆开 apk 逐项核对：旧口径 `4F` 全包**一处也搜不到**；`1F` / `2F` / `3F` 在 `classes*.dex` 里各出现一次（就是那几张楼层表）；
  布局资源里三排井道胶囊（各 4 粒）读出来是 `B / 1F / 2F / 3F`，"你在哪"两粒仍是 `1F / 2F`。
- ✅ **v12**：底线核对：呼梯下发入口仍然只有 **2 个**（▲/▼ 点击 + HTTP 接口，都经过 `tryCall()` 白名单）、
  `tryCall()` 里的白名单依然是 `deviceFloors`（**还是 1F / 2F，没动**）；
  `CarFloorSource` 的 slot 1 依然只有摄像头页会写（乙梯"随机跑"**只在界面里**，不进 `CarFloorSource`）。
- ✅ **v12**：apk 文件本体 **5,938,259 B，SHA-256 前 16 位 `DB33330A11D6C10A`**（干净重编后的包，没有打包空洞）。
- ✅ **v11**：`gradle assembleDebug` **编译通过**（动了 9 个源文件之后重编，53 秒）。
  拆开 apk 逐字符串核对：新文案 `点 1F/2F + ▲▼ 呼梯` 在 `resources.arsc` 里、新提示
  `本演示只有 1F / 2F` 在 `classes*.dex` 里；旧口径 `点 2F/3F + ▲▼ 呼梯`、`本演示只有 2F / 3F` **搜不到**。
- ✅ **v11**：底线核对：呼梯下发入口仍然只有 **2 个**（▲/▼ 点击 + HTTP 接口，都经过 `tryCall()` 白名单）、
  `tryCall()` 里的白名单依然是 `deviceFloors`（已换成 1F/2F）；
  `CarFloorSource` 的 slot 1 依然只有摄像头页会写（乙梯"随机跑"**只在界面里**，不进 `CarFloorSource`）。
- ✅（v10）`gradle assembleDebug` **编译通过**（删了两个文件、动了 4 个源文件之后重新编的）。
- ✅ 把 apk **拆开翻里面的 `resources.arsc` / `classes*.dex`**，逐个字符串核对：
  - **旧东西真的没了**（dex 和 arsc 里都搜不到）：`VoiceController`、`VoiceParse`、`SpeechRecognizer`、
    `btnVoice`、`bigVoice`、`voice_off`、`voice_on`、`mock_big_voice`、`ic_mic`、`RECORD_AUDIO`、
    `聆听中`、`麦克风`。
    （唯一还能搜到"语音"两字的地方是 **appcompat 自带的中文词条** `语音搜索`（`abc_shareactionprovider_voice_search`），
    那是库里的分享菜单文案，**和我们的界面无关**。）
  - **新东西在**：`floorDisplayB`、`elevatorViewB`（主界面第二台电梯的层显和井道）、
    新文案 `甲梯跟着你走 · 乙梯是另一台（模拟）· 点 2F/3F + ▲▼ 呼梯`。
- ✅ **合并后的 `AndroidManifest.xml` 里没有 `RECORD_AUDIO`** —— 只剩
  `BLUETOOTH` / `BLUETOOTH_ADMIN` / `ACCESS_FINE_LOCATION`（≤ Android 11）、
  `BLUETOOTH_SCAN` / `BLUETOOTH_CONNECT`（Android 12+）、`CAMERA`、`INTERNET`。
  **装 v10 不会再弹麦克风权限请求。**
- ✅ 网页版两个页面（`teammate_app_mock.html` / `elevator_ui_preview.html`）过了 **JS 语法检查**。
- ✅（v10 当时）`preflight.ps1` 全绿（包与 zip 逐字节一致、APK 比源码新、固件常量没动、没有 `ELEV-1F` 残留、没有两个版本的包同时在盘上）。
- ✅ 底线核对：`sendCommand(` 依然只有 **2 处**调用（▲/▼ 的点击 + HTTP 接口）、
  `refreshUi()` 里没有 `sendCommand`、`tryCall()` 依然拒绝没装置的楼层、
  `CarFloorSource` 的 slot 1 依然只有摄像头页会写（乙梯"随机跑"**只在界面里**，不进 `CarFloorSource`）。
- ✅ v9 / v8 的验证结论依然有效（两台层显各 175px 且压在自己井道上、门开后有 6 种颜色变化等）。

## 没验过的地方（说清楚）

- ⚠️ **v12 把井道楼层改成 `B / 1F / 2F / 3F` 之后**，真机上层显 / 胶囊里那个单字母 `B` 好不好看、灰掉的 B / 3F 是不是一眼能认出来，只有你装了才知道。
- ⚠️ **安卓真机界面我这边看不到**（没有能跑安卓界面的环境）——
  **v9 主界面改成两台电梯之后，两个层显 + 两台井道在真机上够不够高、挤不挤**，
  只有你装了才知道（层显宽度是按"各占一半"算的，任何屏宽都不会溢出；井道会自动占剩下的高度）。
- ⚠️ **v10 删掉语音按钮之后主界面高度变化**：按钮少了 46dp + 16dp 边距，理论上**更宽松**；
  但真机上按钮位置/间距好不好看还是只有你装了才知道。
- ⚠️ **开门效果**（v8）在网页版上逐像素量过，但手机上看着好不好看只有你装了才知道；
  乙梯随机跑会不会太快/太慢也一样。**不满意说一声我再调**（乙梯间隔现在是 3~4.6 秒；开门停 1.8 秒）。
- ⚠️ **蓝牙判层的实际灵敏度没在真机上验过**：信号强弱会受轿厢（金属盒子）、楼层之间隔板影响，
  **门槛参数必须现场实地调**（怎么调见 `发给队友/NAV_APP_UI_SPEC.md` §7）。
- ⚠️ 真机照片里**只见过数字 `1`**（2/3/4 是合成图验的）；**从没见过"两台电梯同屏"的真实照片**
  —— "左甲右乙"是按屏上两位的**位置**来分的。

## 不含什么

- **不含** ESP32 固件 —— 那是 `烧录程序` 包（v8：本批同步把舵机按压摆角从 40° 改成 60°，App 侧不用跟着改）。
- **不含** BLE 协议规格 —— 那在 `发给队友` 那个包里（`BLE_PROTOCOL.md`）。
- `/api/status` 的字段表也在 `发给队友` 包里（`API.md` + `IOS_INTEGRATION.md`）。

## 版本对不上怎么办

本包是 **v12**（**v1 ~ v11 已被本包取代，旧 zip 和旧 apk 都已删除**）。
本批它和 `烧录程序` **一起更新**（互不依赖）：App 把井道四层改成 **B / 1F / 2F / 3F**（装置仍在 1F / 2F）；
`烧录程序` 升到 **v8**（舵机按压摆角 40° → 60°：从垂直左偏 20° 摆到右偏 40°）。
其它包本批**未动**：`发给队友` 仍 v1.5、`发给队友_到站检测` 仍 v1、`发给队友_透视井道` 仍 v1、`演示材料` 仍 v2、`项目资料` 仍 v1。

以后只要再动 App 的界面或逻辑，就会**重新打包并升版本号（下一版 v13）**，并在这里写清楚改了什么。
