Mocen-Bear/Mocen_Elevator_Ctrl/packages/发给队友_到站检测/_版本信息.md

# 追加包 · 版本信息

- **包名：发给队友_到站检测**（独立追加包，**不属于**主资料包 `发给队友`）
- **版本：v1**
- **打包日期：2026-10-17**
- **重建记录：本包在同一天夜里重建过一次**（版本号**不升**，因为它**还没有发给过任何人**）。
  改了什么：① 频率上限 5200 → **1900**（4 kHz 采样奈奎斯特只有 2 kHz，5200 是无效值）；
  ② 记录了一个**已修的真 bug**：过零只数上升沿却用"上下沿"的公式，频率被算小一半；③ 新增用 `preview/chime_calib.html` 标定的办法。详见 `CAR_POSITION.md` §7。**

## 这是什么

主资料包（`发给队友` v1.0，那 3 份）解决的是 **"靠近电梯 → 按钮浮出来 → 按下去"**，
`发给队友_透视井道`（v1）解决的是 **"在 AR 里看见井道"**。

这个追加包解决的是第三个、也是**对方最容易问穿的一个**：

> **"你怎么知道轿厢现在在几楼？"**

答案是：**现有两块 ESP32 测不出来**（它们只会按按钮）。要真知道，只能在外面再加一个传感器。
本包给出两条**已经写好代码**的路子：

| 路子 | 文件 | 状态 |
|---|---|---|
| **B. 听电梯到站的"叮"声** | `firmware/chime_node/chime_node.ino`（固件）+ 本文 §2 | 编译通过 ✅ / **未上机标定** ⚠️ |
| **D. 摄像头读电梯自带的楼层显示** | `preview/floor_display_reader.html`（网页原型）+ 本文 §3 | 已跑通并**实测出准确率** ✅ |

**主包不做这两件事也完全能演示**（轿厢位置用模拟、界面上标"模拟"即可）。
本包只是让"真实位置"这件事从"我们承认做不到"变成"我们有一条能落地的路"。

## 包含的文件（就这 1 份）

| 文件 | 内容 | 源文件最后修改 | SHA-256（前 16 位） |
|---|---|---|---|
| `CAR_POSITION.md` | 四种轿厢位置来源对比；听"叮"声固件的接线/原理/**现场标定步骤（含专用标定台）**/新增 BLE 协议 `xF\|CAR:CHIME`；摄像头读楼层显示的算法与**实测准确率**；手机侧融合优先级；验收清单；边界与风险 | 2026-10-17 02:5x | `6392AF4180290B91` |

> 注：本包里提到的两个源文件（`firmware/chime_node/`、`preview/floor_display_reader.html`）**不在本包内**，
> 它们是本仓库里的工作产物。要看/要用它们，找我要或者去仓库里拿。

## 一个必须承认的前提

**B 还没上机标定。** 不同大楼的电梯提示音差别很大（有的很轻、有的在轿厢内响、有的压根没有）。
所以 `CAR_POSITION.md` §6 写死了三条：

1. 现场先试 B，**不灵就退回"模拟"并标注**；
2. **D 需要大厅真的有数字楼层显示**（本项目还没实地确认过 —— 出门前先拍一张照片确认数字 ≥ 20 px）；
3. 只要轿厢位置不是来自 B/C/D，**UI 上就必须有"模拟"标记**。这条不能省。

## 版本对不上怎么办

本包版本号是 **v1**。它**不改动主资料包**（`发给队友` 仍是 v1.0，三份文件一字未动）。
以后若要把 `CAR:*` 这段并进 `BLE_PROTOCOL.md`，那才需要把**主包升到 v1.1** —— 那是一次**独立的**升级，
会在这里和主包里都写清楚。
