Mocen-Bear/Mocen_Elevator_Ctrl/presentation/elevator-linkage/改动说明.md

# 队友 PPT · 补的两页（电梯联动）

- 来源：`校园室内外导航展示.pptx`（队友版，16 页，16:9）
- 产物：`校园室内外导航展示_补电梯功能.pptx`（**18 页**，只多了两页，其余页一字未动）

---

## 一、加了哪两页

插在**第 13 页「呼梯装置：向后抽拉式」之后**，电梯这条线接着往下走：

### 新第 14 页 · 电梯联动：看得见的井道
- 一句话：两台电梯现在在哪一层，手机里直接看得见——不用再抬头找层显。
- 三步：① 甲乙两台一起看 ② 真 3D 井道（手指拖动旋转，松手不自动转）③ 随时手动呼梯（▲ / ▼，收到确认才算完成）
- 右侧浅色图板：3D 井道截图 + 全屏电梯详情页截图

### 新第 15 页 · 电梯联动：判定与边界
- 01 **走近就知道你在哪层** — 只听蓝牙信号强弱判层，不用配对、不用手选
- 02 **不抖、不乱跳** — 中位数 + 平滑 + 滞后 + 连续确认，站在两层正中间也不来回跳
- 03 **只替人按一下** — 全程没有任何自动呼梯；不碰控制柜、不改电梯线路，装置整体可取下来；同一台装置可同时服务多台手机

---

## 二、画风是怎么"一致"的

没有照着做一遍，而是**直接克隆原文件自己的页面**：

| 做法 | 说明 |
|---|---|
| 整页克隆 | 新第 14 页 = 复制第 12 页的全部图形与文本框；新第 15 页 = 复制第 9 页的三张白卡 |
| 版式 | 与全文一样用 `CONTENT` 版式；坐标沿用同一套网格（L0.60 / T0.45 / T0.82 / T1.85 …） |
| 字体 | `PingFang SC`（拉丁/东亚/复杂文种三处都写了） |
| 配色 | `#1D4ED8` 强调蓝 · `#14201B` 标题墨 · `#4B5862` 正文灰 · `#EEF1EC` 浅色图板 · `#FFFFFF` 白卡 |
| 细节 | 页码圆点 0.46 in、卡片圆角 adj 3642、卡片浅描边 `#CCD2D8` + 外阴影、行距 130% / 120% —— 全部原样继承 |
| 只改的 | 文字内容；另插入 2 张截图（按原始比例摆放，未拉伸） |

页码用了原生"幻灯片编号"字段，PowerPoint 打开会自动显示 14 / 15。

---

## 三、需要你拍板的一点

新第 14 页用的两张截图（`配图_电梯联动/04_3D井道预览.png`、`02_全屏电梯详情页.png`）是**旧版井道**：
图里还写着 `2F / 3F`、楼层按钮是 `1F~4F`。
而现在的口径是 **井道 B/1F/2F/3F，装置装在 1F 和 2F**（固件 v8、App v12 都是这个）。

要重出这两张截图的话，得先按新口径把出图用的预览页改一遍（就是之前暂停的那轮 `preview/*.html` 清理），再重新截图、重新塞进这两页。

---

## 四、目录

```
队友PPT_补页/
├── 校园室内外导航展示_补电梯功能.pptx   ← 给队友的文件（18 页）
├── 改动说明.md                          ← 本文件
└── 预览/                                ← 新增两页的近似预览图（字体用微软雅黑代替 PingFang SC）
    ├── 新第14页_预览.png
    └── 新第15页_预览.png
```
