Mocen-Bear/Mocen_Elevator_Ctrl/docs/演示材料/_版本信息.md

# 演示材料 · 版本信息

- **包名：演示材料**（**给自己人看的**，不是给队友的接口文档）
- **版本：v2**（v1 已删除）
- **打包日期：2026-10-18**

## v2 改了什么（起因：App 里的语音删了）

**一句话**：App v10 把**语音呼梯**整条删掉了（真机上手机自带识别不准），
所以这个包里凡是"**语音也能呼梯**""**3 个能发命令的入口**""**演出第 ⑧ 拍是语音**"的说法**全部改掉**。

| # | 改了什么 | 为什么 |
|---|---|---|
| 1 | `能力与边界.md` 第 2 条：**"3 个能真正发命令的入口（▲/▼ 按钮、语音、HTTP 接口）" → "2 个"**（▲/▼ 按钮、HTTP 接口） | 语音入口在 App v10 已删。**这是安全题的标准答法，绝不能说错** |
| 2 | `能力与边界.md` 第 9 条演出节拍：`…→到站→语音` → `…→到站→门开→再按一次「下行」` | 演出页 `storyboard.html` 的第 ⑧ 拍已经改成"再按一次下行" |
| 3 | `现场演示手册.md` 3 分钟脚本 **1:20 那一拍**：从"语音'我要去 3 楼'"改成"**在 App 里点 ▲/▼ 再呼一次**"，台词保留原来的语义（**呼的永远是"你所在那一层"的按钮**，目的地只决定上/下） | 现场照着念的稿子，不能指向一个已经不存在的按钮 |
| 4 | `现场演示手册.md` 出问题对照表里"什么都跑不起来"那条：30 秒演出的节拍同步改成 `…到站→门开→再按一次下行` | 同上（那条是"全崩了就看动画"的保险） |
| 5 | `现场演示手册.md` 问答表"会不会自己乱按"：**3 个入口 → 2 个**（并注明 App 里的语音入口 v10 已删） | 同上，和 `能力与边界.md` 保持一致 |
| 6 | `现场演示手册.md` 最后一分钟检查：删掉"**静音不要关（语音那段要用）**"，只留"手机亮度拉满" | 都没有语音了，静音无关 |
| 7 | `现场演示手册.md` §1 清单里的"**装 App**"：从写死的 `app-debug.apk（今晚 02:18 那份）`改成 **`安卓App/电梯呼叫_v10.apk`**（并注明"别再装 v9 或更早的"） | 原来那句是当时的临时话术，早过期了；现在直接指包里的 apk 最稳 |
| 8 | 两份文档末尾各加一段 **"本手册/本页属 `演示材料` v2"** 的改动说明 | 让对方（自己人）一眼知道这份是新是旧 |
| 9 | 顺手把本文件里写死的 **"`发给队友` v1.0"** 改成 **v1.5** | 原来那两处是 v1 时留下的过期引用；既然这次动本包，就一起改对 |

**没有改的**：`BLE_PROTOCOL.md` / `firmware/` / `SHAFT_MODEL.md` / `CAR_POSITION.md` / `preview/` 里任何文件
—— 本包**只读**它们。**固件、协议、呼梯语义、判定参数、红线**（永不自动呼梯 / 1F·4F 拒呼）**一字未动**。

## v1 的历史（当时改了 8 次，版本号一直没升 —— 因为它从未外发过）

| # | 改了什么 | 为什么 |
|---|---|---|
| 1 | 补进**判定算法离线仿真**（`preview/rssi_floor_sim.html`）的实测数字：静止 0 抖、最坏位置 25.7 → 1.3 次 | "瞬时/不抖"从感觉变成数字 |
| 2 | 把**到站"叮"声标定台**（`preview/chime_calib.html`）写进出发清单；把标定时抓出并修掉的**固件频率 bug** 记进能力表 | 现场标定从"猜数字"变成"抄四行宏" |
| 3 | 出发清单最前面加**一键体检脚本 `preflight.ps1`** | 包一致性 / APK 新旧 / 固件常量 / 残留 `ELEV-1F` 全自动查 |
| 4 | **改"40 ms vs 200 ms"的口径**：查 `BleManager.kt` 后统一写成 **40~200 ms**（40 ms = 扫到新广播后重判的节流上限，200 ms = 心跳兜底），并注明"仿真故意按最保守的 200 ms 跑"；顺带修掉问答表里一处过期的"能做的 6 条" | 原来幻灯片里两个数并存，被追问时自己先说不圆 |
| 5 | 修**预览页清单**（原文写"四页"却列了五页，且漏了幻灯片）→ 改成 8 页并写明**上台顺序**；给 APK 写上**确切路径 + 打包时间**；把演示脚本里语音那句改成**正确语义**（按"你所在的那层"，不是"目的层"） | 现场照着手册走，不能有歧义 |
| 6 | 把**三条硬红线在源码里逐条验证**后写进问答表：**永不自动呼梯**（判定/信号回调里一行呼梯代码都没有）、**只有 3 个人工入口**、**1F/4F 手动选也拒呼**；能力表第 2、5 条补上可指认的代码位置 | "它会不会自己乱按"是必被问的安全题，现在能**指着代码**回答 |
| 7 | 新增 **`preview/ble_console.html` 现场蓝牙控制台**（Web 蓝牙）：手机 App 扫不到装置时，用**笔记本 Chrome** 直接发 `UP`/`DOWN` 并看回执，也能连 `CHIME-*` 看它报不报 `CAR:CHIME`。出发清单里预览页 **8 → 9 页**；出问题对照表"手机扫不到"那行补上这条退路；`preflight.ps1` 的页面清单同步加进这一页 | 现场最可能挂的就是**手机端**；这条退路只要一台笔记本 + 浏览器，不依赖 App |
| 8 | **去掉本手册里写死的页数**（"共 9 页" → "以 `index.html` 演示台为准，它会自动数"），同时 `preflight.ps1` 与演示台也改成**自动统计页数** | 已知后面**还要往 `preview/` 加新方案**；写死的数字会立刻过期，还会让这个包动不动就"需要重建" |

> ⚠️ 第 6 条里写的"**只有 3 个人工入口**"，在 App v10 之后**已经是 2 个**（见上面 v2 第 1 条）。
> 上面的历史表**故意保留原样**，看的时候记得那是个时间点。

## 这是什么

主资料包那三个包解决的是**"东西怎么做"**：
`发给队友`（v1.5，6 份）= 近距呼梯（含接口规格与那份真 3D 井道网页）；`发给队友_透视井道`（v1）= AR 井道；
`发给队友_到站检测`（v1）= 真实位置的两条路（摄像头 + 听"叮"声）。

**这个包解决的是"项目那天怎么不出事、怎么答得漂亮"**：一份操作手册 + 一份问答底稿。

## 包含的文件

| 文件 | 内容 | 源文件最后修改 | SHA-256（前 16 位） |
|---|---|---|---|
| `现场演示手册.md` | 出发前一晚清单（**先跑 `preflight.ps1` 一键体检** / 烧固件 / 舵机供电 / **拍楼层显示照片** / **`preview/` 全部页面的上台顺序**（页数以演示台为准，含**蓝牙控制台退路**）/ `http://` 下摄像头与蓝牙被拦的绕法 / 可选到站检测节点）、到场 10 分钟落地步骤（含**用调参器选现场判定参数**）、3 分钟演示脚本（谁说什么，含呼梯语义；**1:20 那一拍已改成"再按一次 ▲/▼"**）、**出问题对照表**（含"手机扫不到"→ 笔记本开 `ble_console.html` 顶上；含"全崩了就用故事板放映"这条保险）、常见问答速查（含"到底几毫秒"的统一口径 + **"会不会自己乱按"的安全答法**）、最后一分钟检查 | 2026-10-18 01:18 | `E2B2A87358900930` |
| `能力与边界.md` | **能做的 10 条 + 明确做不到的 5 条 + 三个最可能被追问的逐字答法**。每条都写了证据在哪个文件（含"40~200 ms"口径与源码位置；含**三条硬红线**的代码级证据：判定回调无呼梯代码 / **只有 2 个人工入口** / 1F·4F 拒呼；含已修的固件频率 bug） | 2026-10-18 01:17 | `4397B035E9340CD2` |

> 本文件 `_版本信息.md` 也在这个包里（内容就是这个）。
> 装 App 请用 `安卓App/电梯呼叫_v10.apk`（**本包不含 apk**）。

## 用法（两句话）

1. **出发前一晚**照 `现场演示手册.md §1` 勾一遍（第一项就是跑 `preflight.ps1`），
   特别是"**拍一张大厅楼层显示的照片**" —— 这一张照片决定摄像头方案能不能用。
2. **上台前**把 `能力与边界.md §C` 那三个问题的答法看一眼。**先认边界，再给真路**，可信度最高。

## 这一包和别的包的关系

**本包只读别的包，不改别的包。** 它引用了 `BLE_PROTOCOL.md`、`SHAFT_MODEL.md`、`CAR_POSITION.md`、
`firmware/`、`android/`、`preview/`，但这些文件的**内容一字未动**（`preview/` 属于工作产物，不在任何包里）。

> ⚠️ 唯一一处"看起来越界"的是 v2 顺手修的本文件里那两行 `发给队友` 版本引用 ——
> 那只是**本包自己文件里的文字**。（顺带一提：**同一天 `发给队友` 自己也升到了 v1.5** ——
> 因为 `NAV_APP_UI_SPEC.md` §10 有一句"我们安卓版数字下面写 `蓝牙判层`"和安卓 v9 之后对不上，被更正了。
> 那是**另一个包的事**，与本包内容无关。）

## 版本对不上怎么办

本包版本号是 **v2**。它**不影响**主资料包（`发给队友` 仍是 **v1.5**）、
也不影响 `安卓App`（**v10**）、`烧录程序`（**v5**）。

## 怎么确认这个包没坏

在仓库根目录跑一条命令，它会解压本包、逐字节比对文件夹里的文件：

```powershell
powershell -ExecutionPolicy Bypass -File .\preflight.ps1
```
