Mocen-Bear/Mocen_Elevator_Ctrl/docs/media/elevator-linkage/文案_电梯联动_给队友.md

# 电梯联动 · 给队友的文案

> 用途：给队友放进 PPT / 演示页的说明文字。
> 已按要求去掉所有**专有名词、设备与广播名称、具体数值**（不出现 ELEV-xF / ESP32 / RSSI / dBm / 协议回执 / 舵机型号 / 协议文件名）。

---

## 标题

电梯联动 · 手机就是呼梯按钮

## 一句话

不用碰公共按钮：走近电梯厅，手机自己浮出呼梯按钮，点一下就把电梯叫来。

## 三种状态

1. **还没走近** —— 界面安静，不显示任何按钮，导航照常带路。
2. **走近电梯** —— 右侧浮出一个小圆钮，写着“要按哪一层、往上还是往下”。点一下＝呼梯；向左一拖＝看电梯详情。
3. **电梯详情页** —— 甲、乙两台电梯各自在哪层一目了然，下面 ▲ / ▼ 可以手动呼梯。

## 几条规则（好懂版）

- 按哪一层的按钮 ＝ 你当前在哪一层；往上还是往下 ＝ 目的地比你现在的楼层高还是低。
- 你就在这一层、要去的也是这一层 → 不显示按钮（不用坐电梯）。
- 走近了才出现，走远了自动收起。
- 点下去要等到“已按下”的确认，这一次呼梯才算完成；这期间按钮会短暂锁住，防止连点。
- 两台手机一起用也互不影响。

## 为什么做成向后抽拉式（收尾 · 要强调）

装置平时**收在后面**——藏得住、看着干净；要用的时候才伸出来按一下，按完立刻退回。

**隐藏 · 美观，而且不占按钮前面的位置，完全不影响正常乘客自己按电梯。**

## 超短版（版面挤的时候用）

> 走近电梯厅，手机自己浮出呼梯按钮，点一下就把电梯叫来——不用碰公共按钮。
> 按钮平时藏起来、要用才伸出，收得干净，也不挡乘客自己按电梯。
