Mocen-Bear/Mocen_Elevator_Ctrl/docs/media/elevator-linkage/01_导航浮窗_接近电梯.png

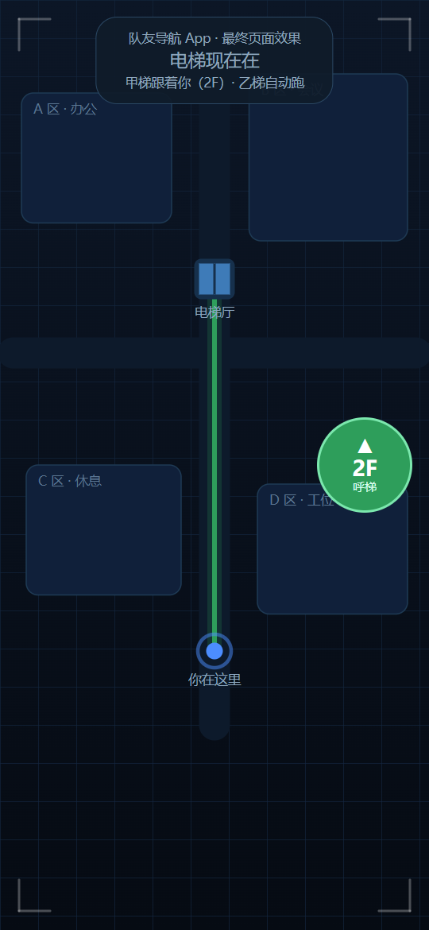
docs/media/elevator-linkage/01_导航浮窗_接近电梯.png
