Mocen-Bear/Mocen_Elevator_Ctrl/docs/media/elevator-linkage/03_交互三态_说明板.png

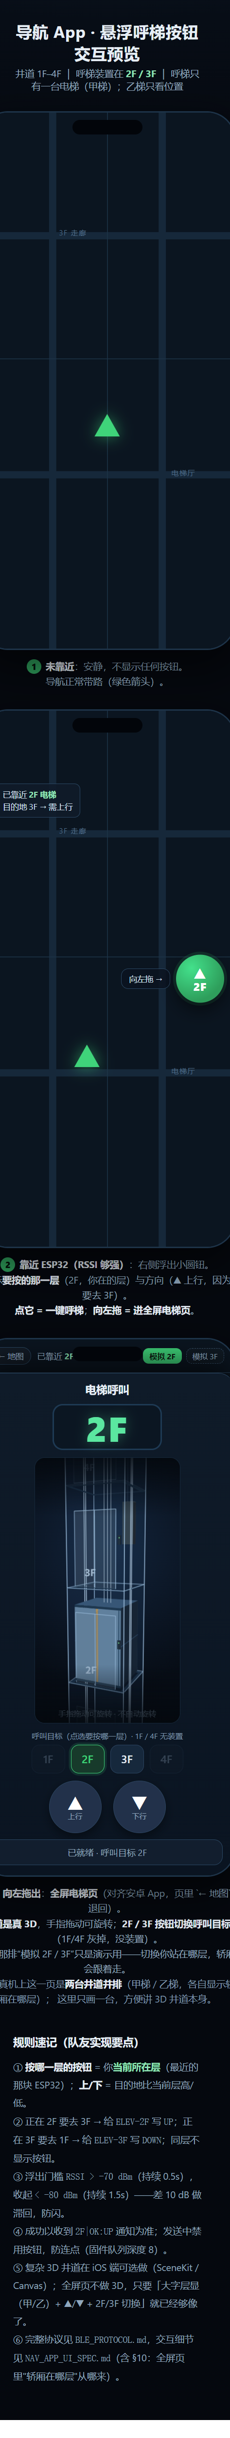
docs/media/elevator-linkage/03_交互三态_说明板.png
