Mocen-Bear/Mocen_Elevator_Ctrl/mech/renders/04_剖视_静止.png

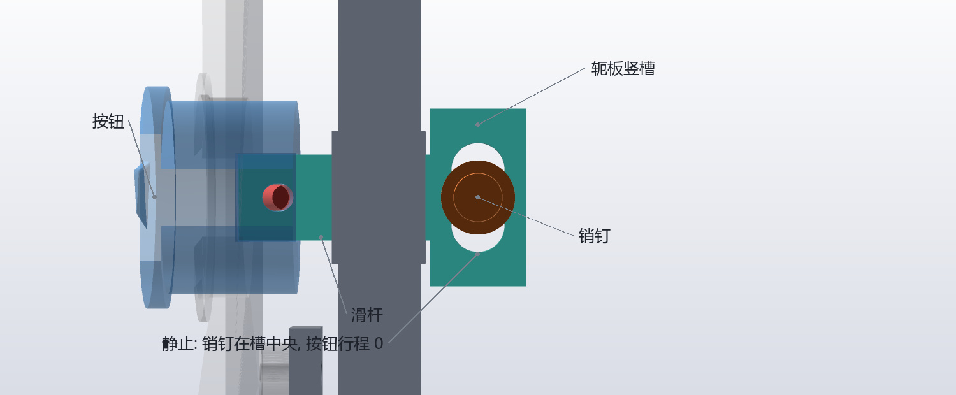
mech/renders/04_剖视_静止.png
