Mocen-Bear/Mocen_Elevator_Ctrl/presentation/elevator-linkage/preview/新第14页_预览.png

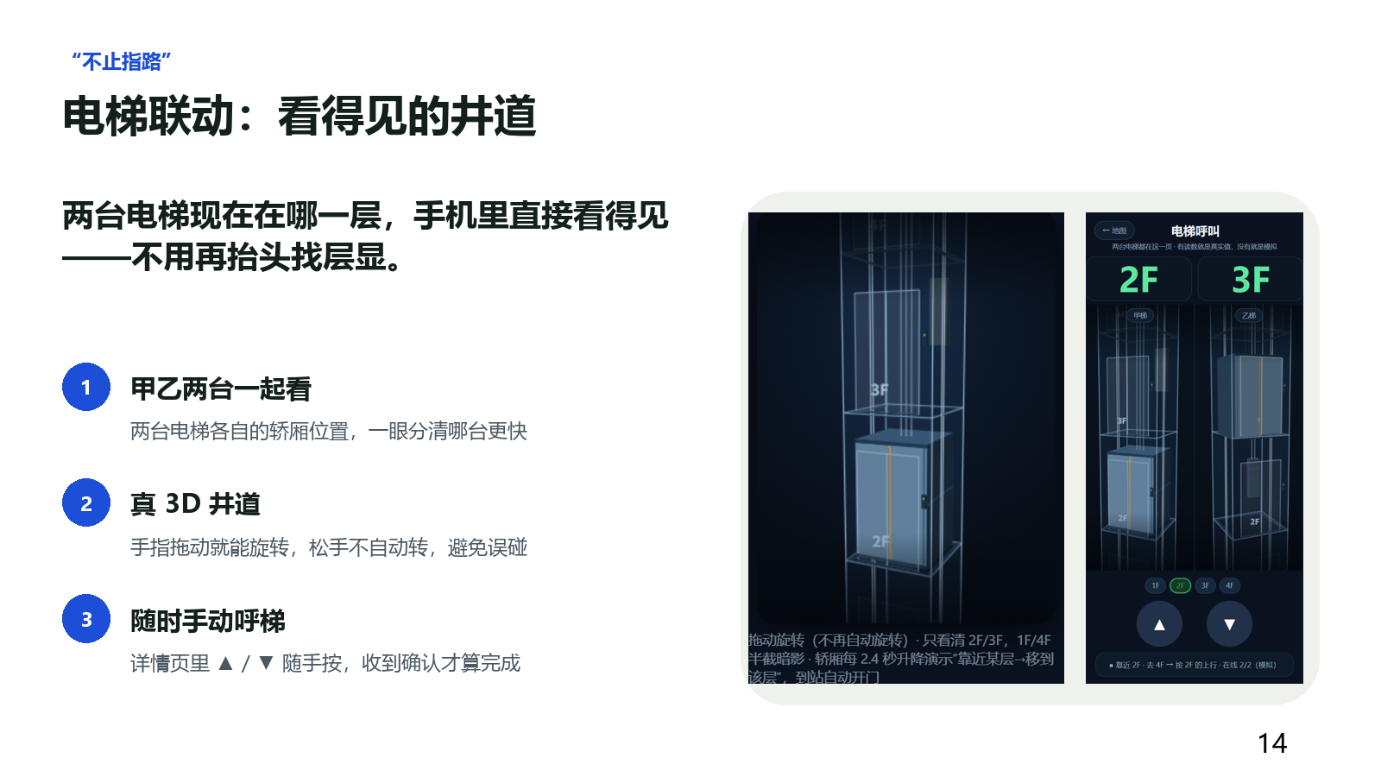
presentation/elevator-linkage/preview/新第14页_预览.png
