Mocen-Bear/Mocen_Elevator_Ctrl/presentation/elevator-linkage/preview/新第15页_预览.png

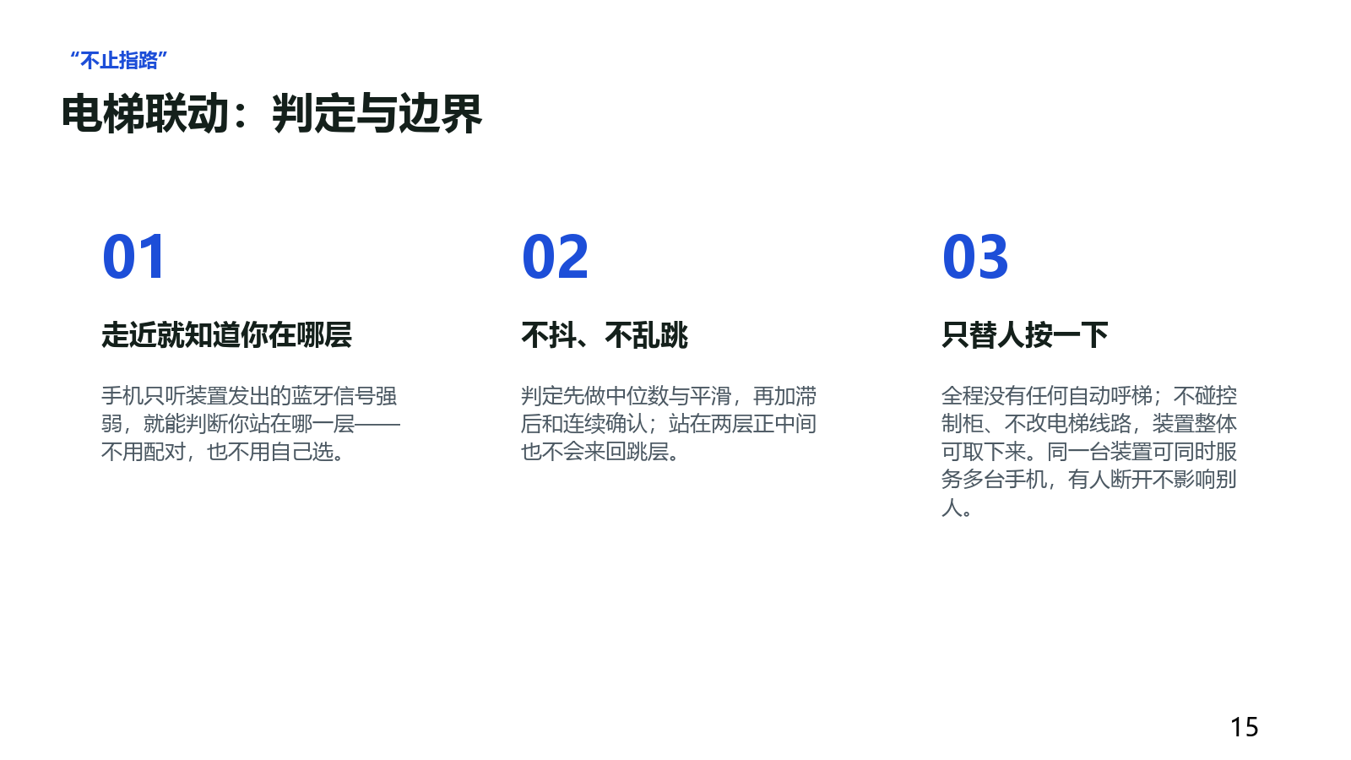
presentation/elevator-linkage/preview/新第15页_预览.png
