Mocen-Bear/Mocen_Elevator_Ctrl/mech/stl/05_滑块.stl

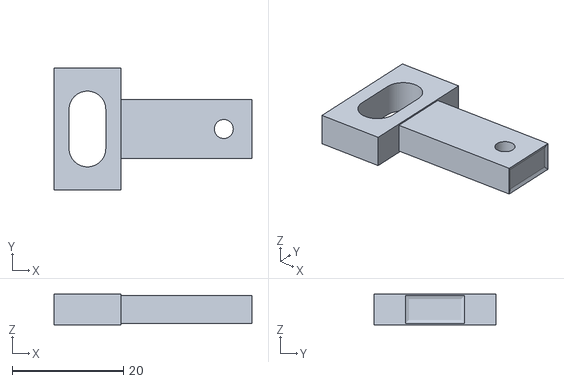
[picture p36: CAD file, 2026-11-01]
mech/stl/05_滑块.stl
35.6 x 22.0 x 5.50
