Mocen-Bear/Mocen_Elevator_Ctrl/mech/stl/03_按钮_上.stl

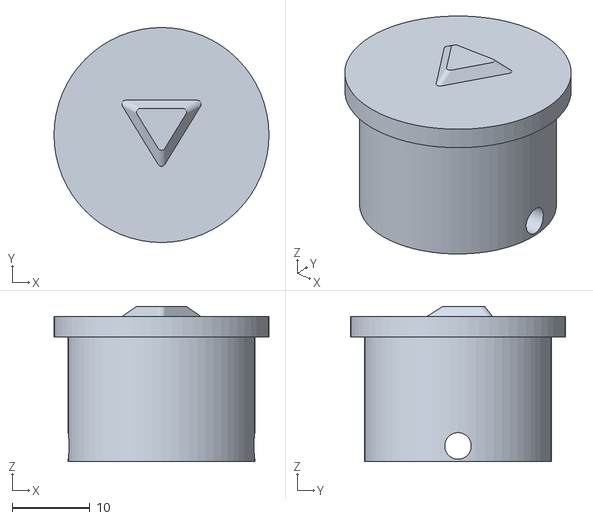
[picture p37: CAD file, 2026-11-01]
mech/stl/03_按钮_上.stl
27.6 x 27.6 x 19.9
