Mocen-Bear/Mocen_Elevator_Ctrl/mech/stl/01_底座.stl

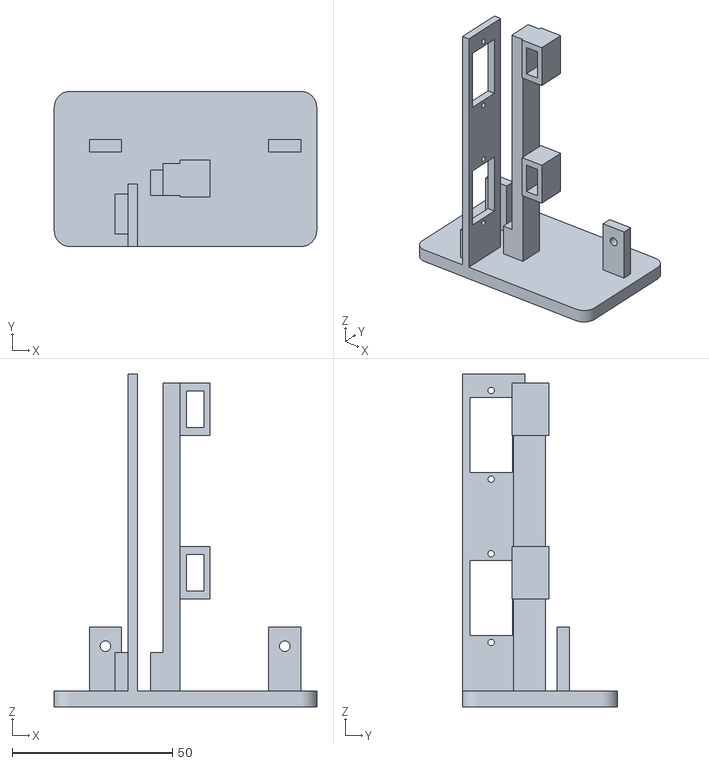
[picture p38: CAD file, 2026-11-01]
mech/stl/01_底座.stl
82.0 x 48.5 x 104.0
