Mocen-Bear/Mocen_Elevator_Ctrl/mech/stl/08_连接销.stl

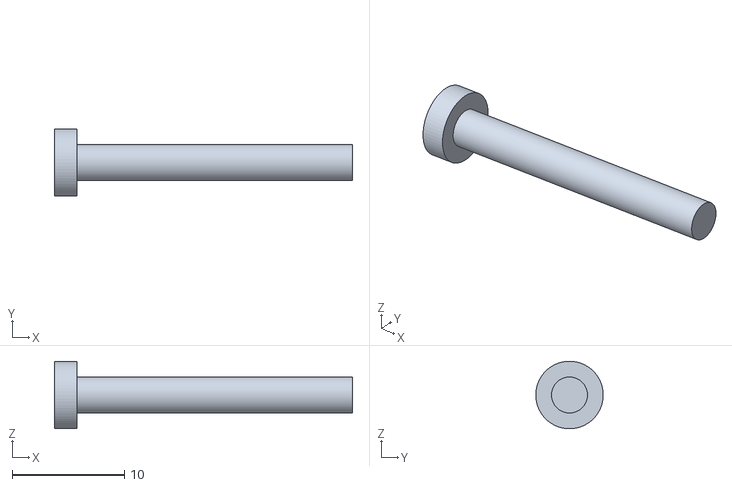
[picture p39: CAD file, 2026-11-01]
mech/stl/08_连接销.stl
26.5 x 6.00 x 6.00
