Mocen-Bear/Mocen_Elevator_Ctrl/mech/stl/02_面板.stl

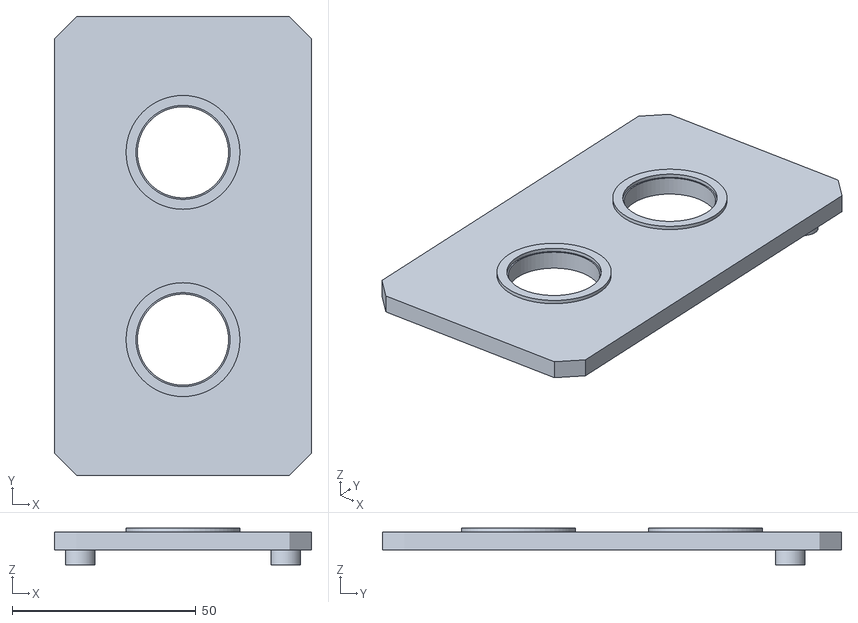
[picture p40: CAD file, 2026-11-01]
mech/stl/02_面板.stl
70.0 x 125.0 x 10.0
