Mocen-Bear/Mocen_Elevator_Ctrl/mech/stl/06_曲柄.stl

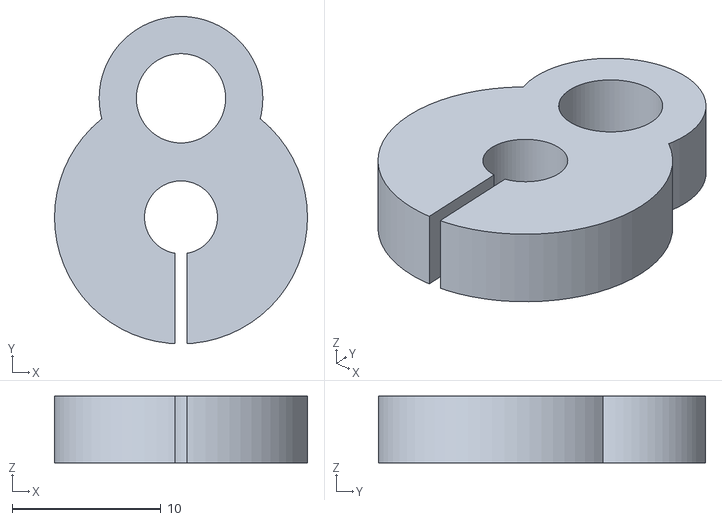
[picture p41: CAD file, 2026-11-01]
mech/stl/06_曲柄.stl
17.0 x 22.0 x 4.50
