Mocen-Bear/Mocen_Elevator_Ctrl/mech/stl/07_销钉.stl

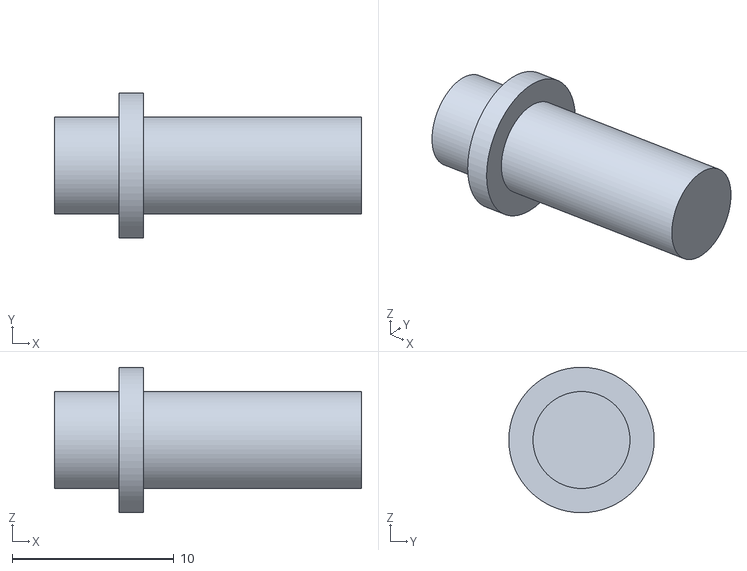
[picture p42: CAD file, 2026-11-01]
mech/stl/07_销钉.stl
19.0 x 9.00 x 9.00
