Mocen-Bear/Mocen_Elevator_Ctrl/(list of files, cad)

Other CAD files:
mech/stl/04_按钮_下.stl
