Mocen-Bear/Mocen_Elevator_Ctrl/mech/说明书_装配与使用.md

# MG90S 电梯按钮「后拉」演示样机 —— 装配与使用说明

> 版本 v1 ｜ 全部尺寸单位 mm ｜ 打印件 8 个 STL，无胶、全螺丝/插销装配

---

## 1. 这东西是什么

一块**假面板**（70 × 125 × 5），上面装两个**假按钮**（一个 ▲ 上行、一个 ▼ 下行）。
面板背面装两台 **MG90S 舵机**，舵机一转，通过连杆把按钮**往后拉** 3 mm。

它的作用：**放在桌上，让你亲眼看到"按钮被拉下去了"**。
它不是真电梯按钮，也不接触任何真电梯——就是一个能拿在手里演示的模型。

- 按钮不是"被按压"，而是**从后面被拉进去**（真实电梯里很多按钮也是这个原理）。
- 手也能按（往前推 3 mm 就到底），松手后舵机可以把它顶回来。
- 全程**不用一滴胶水**：用过盈压配、插销、螺丝。

---

## 2. 工作原理：曲柄 + 竖槽（苏格兰轭）

```
        舵机轴（朝你）
             │
        ┌────┴────┐   曲柄（橙色）
        │    ●────┼──→ 销钉
        └─────────┘
                 │
                 ↓ 销钉插进这块板上的【竖槽】里
            ┌─────────┐
            │  ║槽    │   滑块 / 轭板（青色）
            └─────────┘
                 │
                 ↓ 滑杆伸出去，插进按钮屁股后面的方孔
             [按钮]
```

- 舵机转一个小角度 → 销钉绕圈走。
- 销钉在**竖槽**里上下滑（这个方向的力被放掉），只剩**前后方向**的分量推动滑块。
- 于是舵机一转，滑块就**笔直地前后走**，按钮跟着前后走。

**关键数字**：滑块行程 = 曲柄半径 × sin(角度)

| 舵机转角 | 按钮行程 |
|---|---|
| 22° | 3.0 mm ← 默认工作行程 |
| 30° | 4.0 mm ← 机械限位（按钮帽碰到面板凸圈，走不动了）|

曲柄半径 = 8 mm。这个关系是**怎么算都跑不掉**的，所以"拉 3 mm 到底要转多少度"是确定的，可以直接写进固件。

---

## 3. 为什么选这个方案（对比）

| | 甲：我们最早的滑块曲柄 | 乙：收到的苏格兰轭方案 | **丙：本次合并方案** |
|---|---|---|---|
| 直线运动纯度 | 一般（有侧向分力） | **好（纯直线）** | **好（纯直线）** |
| 销钉受力 | 有侧向弯 | **零侧向力** | **零侧向力** |
| 曲柄固定 | 螺丝压紧 | 胶水粘在舵机摇臂上 | **花键孔 + 夹紧缝 + M3 夹紧螺丝（无胶、可重复对零）** |
| 销钉 | 和曲柄一体 | 和曲柄一体（磨坏就得换整根曲柄） | **独立零件，磨坏只重印 1 个小销钉** |
| 装配难度 | 中 | 高（多处胶水、上盖粘死，修不了） | **中（全部可拆可重装）** |
| 舵机轴心高度误差 | 直接卡死 | 直接卡死 | **竖槽留 ±3.8 mm 容差，装偏一点照样能转** |
| 干涉自检 | 无 | 有工具 | **有（本仓库 `cad/build.py` 自动跑全行程干涉检查）** |

一句话：**保留乙的"纯直线、零侧向力"，换掉它的"全靠胶水 + 坏了没法修"。**

---

## 4. 零件清单

### 4.1 打印件（`stl/` 目录）

| 文件 | 数量 | 说明 |
|---|---|---|
| `01_底座.stl` | 1 | 底板 + 舵机安装墙 + 立柱 + 两个导向块（一件成型） |
| `02_面板.stl` | 1 | 70 × 125 × 5，含按钮孔、正面凸圈（▲▼ 刻在按钮上，不在面板上） |
| `03_按钮_上.stl` | 1 | ▲ 按钮（帽 + 杆 + 后方方孔 + 连接销孔） |
| `04_按钮_下.stl` | 1 | ▼ 按钮（同上，箭头方向相反，箭头为 1 mm 凹刻） |
| `05_滑块.stl` | 2 | 滑杆 + 轭板 + 竖槽（上下层各一个） |
| `06_曲柄.stl` | 2 | 花键孔 + 夹紧缝 + 销钉孔 |
| `07_销钉.stl` | 2 | ⌀6 圆柱 + 法兰，插在曲柄上 |
| `08_连接销.stl` | 2 | ⌀3.2，把按钮和滑杆锁在一起 |

### 4.2 五金件

| 名称 | 规格 | 数量 | 用途 |
|---|---|---|---|
| M3 × 12 自攻螺丝 | 尖头，能拧进塑料 | 4 | 2 颗固定面板（从背后拧进立柱）、2 颗做曲柄夹紧螺丝 |
| M2 × 8 自攻螺丝 | 尖头 | 4 | 固定舵机（舵机自带的 4 颗即可） |
| MG90S 舵机 | 9 g 金属齿 | 2 | 上下各一 |
| 细砂纸 / 美工刀 | — | — | 修打印毛刺、微调孔径 |
| （可选）凡士林 / 硅脂 | 少量 | — | 涂在竖槽和滑杆上，减少摩擦、降噪 |

**不需要**：胶水、轴承、弹簧、联轴器。

### 4.3 塑料用量（PLA）

| | 体积 | 估重 |
|---|---|---|
| 全部零件合计 | 约 97 cm³ | 约 120 g |

最费时的是底座（约 42 g）和面板（约 49 g）。建议**分两次打印**：先打底座 + 面板（长活），再打剩下的 6 个小件（很快）。

---

## 5. 打印参数（Bambu Lab A1 / 0.4 喷嘴）

| 项目 | 建议值 | 备注 |
|---|---|---|
| 材料 | PLA 或 PLA+ | 别用 PETG（弹性大，销钉会松） |
| 层高 | 0.2 mm | 底层 0.25 |
| 墙（外壁） | 3 圈 | 销钉和曲柄建议 4 圈，更耐用 |
| 填充 | 15 %（网格或陀螺） | 底座受力处可 25 % |
| 支撑 | **全部不需要** | 每个零件的摆放姿态在 STL 里已经摆好（见下） |
| 底板附着 | 面板用 brim（防止翘边），其余 skirt 就行 | |
| 速度 | 默认即可 | |

**每个零件在切片软件里应该长这样（STL 已经摆好了，直接切片就行）：**

| 零件 | 摆放姿态 | 为什么 |
|---|---|---|
| 底座 | 底板躺在桌上，舵机墙和立柱朝上 | 全部是竖直墙，不需要支撑 |
| 面板 | 背面朝下平放，凸圈和 ▲▼ 朝上 | 正面效果最好，背面大平面好附着 |
| 按钮 | 杆朝下、帽朝上 | 箭头凹刻印在顶面，最清楚 |
| 滑块 / 曲柄 | 板面平放（竖槽 / 花键孔变成竖直的孔） | 孔圆、尺寸准 |
| 销钉 / 连接销 | 横躺在底板上 | 圆柱更圆、强度更高 |

**装配前必做**：所有孔都用刀尖/钻头顺着转一圈去掉毛刺；`07_销钉` 的 ⌀6 外圆和 `06_曲柄` 的 ⌀6 孔要试插，**能用手压进去、但不会自己掉下来**最合适。太紧就砂纸磨销钉，太松就在销钉上缠一圈透明胶带。

---

## 6. 装配步骤

> 全程用不到胶水。遇到紧的地方**先确认方向对不对，再用力**，别硬砸。

### 第 1 步：舵机装到底座上
1. 把舵机的**输出轴朝向 X 正方向**（朝着按钮那一侧），机身塞进底座舵机墙上的大方孔里。
2. 舵机两侧的耳朵会贴在墙的外面，两个孔对准墙上的两个小孔。
3. 拧上 4 颗舵机自带螺丝（M2）。
4. 上下两台同样装。

> 装好后，舵机轴应该正好从墙的另一面伸出来，**轴上没有东西**。

### 第 2 步：把舵机转回"零位"
1. 先别装曲柄。
2. 通电，用固件（或舵机测试仪）让舵机停在**起始角度**。
   > 起始角度写在固件里（见第 9 节），默认就是让按钮处于"没被按下"的位置。
3. 断电（或保持通电但不要碰轴）。

> 如果现在不接电，也可以先随便装，最后再对零（第 7 步教你怎么对）。

### 第 3 步：曲柄压到花键上
1. 拿起 `06_曲柄`，花键孔对准舵机轴，**用手掌压进去**，压到底（曲柄内侧面贴住舵机凸台）。
2. 曲柄上的**夹紧螺丝先不要拧紧**——现在是松的，曲柄能绕着轴转。
3. 同时，曲柄上那个大孔（⌀6）要朝上（朝向按钮那一侧）。

### 第 4 步：销钉插进曲柄
1. 拿起 `07_销钉`，细的一端从曲柄**内侧**插进 ⌀6 孔。
2. 法兰（大圆片）留在曲柄外侧，压平。
3. 销钉现在应该朝外伸出去约 15 mm，这就是待会儿要插进竖槽的那根。

### 第 5 步：滑块从后面塞进去
1. 拿起 `05_滑块`，**有长条滑杆的那一头朝前（朝面板方向）**。
2. 轭板（带竖槽的那块）从后面套住销钉——**销钉插进竖槽**。
3. 同时，滑杆顺着底座导向块里的方孔往前推。
4. 推到轭板靠近导向块为止（先别推到底）。

> 现在前后推轭板，曲柄应该跟着转，舵机轴也跟着转。转到 3 mm 左右就该被限位挡住。

### 第 6 步：面板拧到底座上
1. 面板背面朝下放在桌上。
2. 底座拿过来，**面板的背面朝底座**，让底座上两根立柱顶住面板背后的两个小圆台。
3. 从底座后方，2 颗 M3 × 12 拧进去（穿过立柱，拧进面板圆台）。
4. 轻轻拧到底就行，别用力过猛把圆台拧裂。

### 第 7 步：按钮从前面插进去 + 对零（关键一步）
这一步决定"按钮静止时露出来多少"。**慢一点，一次就能装好。**

1. 从面板**正面**把按钮（▲ 在上、▼ 在下）的杆插进孔里，帽留在外面。
2. 把按钮往里推，推到你觉得"按钮静止时应该露这么高"的位置。
   - 推荐：**帽背面和面板正面之间留 4~5 mm**（大概是你小指甲的厚度）。
   - 更准的办法：剪一条 4 mm 宽的硬纸片，塞在帽背面和面板之间。
3. 保持按钮不动，把后面的滑块往前推，直到滑杆前端**顶住按钮杆方孔的底**（会"咔"一下到底）。
4. 现在按钮杆上的横孔、和滑杆上的横孔，**应该正好对成一条直线**（这是设计时算好的，顶到底就自动对齐）。
5. 拿 `08_连接销`，从**左边**（滑块那一侧）插进横孔，一直推到只剩一个小头露在外面。
6. 插好后，按钮和滑块就锁死了：推按钮，滑块会跟着动。
7. 最后一步——**给曲柄对零**：
   - 通了电，让舵机停在起始角度；
   - 按住按钮保持在刚才的位置（纸片还塞着）；
   - 这时曲柄应该正好在"销钉在最前"的位置；
   - **拧紧曲柄上的 M3 夹紧螺丝**（从背面伸螺丝刀/内六角进去拧）。
   - 拧紧后曲柄就锁在轴上了，对零完成。
8. 拿走纸片。按钮现在应该停在正确高度，推一下能进去 3~4 mm。

> 上下两层按钮都重复第 3~7 步。

### 第 8 步：检查
- 通电让舵机来回转，按钮应该**干脆地进出**，不卡、不响。
- 手动按按钮，松手能弹回来（靠舵机回位）。
- 如果有点涩：在竖槽、滑杆、销钉上抹一点点凡士林。

---

## 7. 怎么调行程 / 重新对零

| 想要的效果 | 怎么做 |
|---|---|
| 按钮露出来更多/更少 | 松开曲柄夹紧螺丝 → 把曲柄相对轴转一点点 → 重新拧紧 |
| 想让按钮拉得更深 | 改固件里的转动角度（最大只能到 30° / 4 mm，再多会顶到限位） |
| 上下两个按钮行程不一致 | 分别改两个舵机的角度，或分别对零 |
| 按钮有点晃 | 检查连接销是否插到底；检查两个 ⌀6 销钉是否松（缠一圈胶带） |

---

## 8. 固定在哪儿

样机自带一块底板（约 82 × 48 mm），直接**放在桌上**就能演示。

如果想立起来：
- 用双面胶/魔术贴把底板粘在桌边或纸盒侧面；
- 或者把整机放进一个纸盒，面板那面朝外，盒子侧面开个洞让线出来。

底板前面有一小段"舌头"（伸到面板前方 6 mm），是留给双面胶/夹子的。

---

## 9. 接线与固件

| 项目 | 数值 |
|---|---|
| 上行按钮（▲）舵机信号线 | **D13** |
| 下行按钮（▼）舵机信号线 | **D12** |
| 舵机电源 | 外部 5 V（**不要用 ESP32 的 3.3V 供电**，会抖） |
| 共地 | 舵机 GND 必须和 ESP32 GND 接在一起 |

固件里需要**改两个数字**：

```
起点角度 = 0°          （按钮没被拉时的位置）
按下角度 = 22°         （按钮被拉 3 mm 时的位置）
```

> 注意：老固件里写的是 `0 → 180`（那是"用舵机臂去推"的方案）。
> 换成这套机械结构后，**只要 0 → 22 度这一小段**就够了。
> 如果上下两个舵机转向相反，其中一个改成 `0 → -22`（或者把曲柄装到对面）。

---

## 10. 装配尺寸核对表

打印完、装之前，拿卡尺量一下这几个关键尺寸，差太多就先别装：

| 部位 | 应该是 | 允许误差 |
|---|---|---|
| 面板按钮孔 | ⌀24.8 | +0.3 / −0.1 |
| 按钮杆外径 | ⌀24.0 | ±0.2 |
| 按钮杆方孔（宽 × 高）| 5.4 × 11.0 | +0.2 |
| 滑杆截面（宽 × 高）| 5.0 × 10.6 | −0.2 |
| 轭板竖槽宽度（行程方向）| 6.6 | +0.2 |
| 轭板竖槽长度（容差方向）| 13.6 | ±0.3 |
| 销钉外径 | ⌀6.0 | −0.1 |
| 曲柄销钉孔 | ⌀6.0 | +0.1 |
| 曲柄花键孔 | ⌀4.9 | +0.1 |
| 底座导向块方孔 | 5.4 × 11.4 | +0.2 |
| 上下按钮中心距 | 51.0 | ±0.5 |
| 舵机安装耳孔距 | 27.7 | ±0.5 |

---

## 11. 常见问题

| 现象 | 原因 | 处理 |
|---|---|---|
| 按钮推不动 / 很涩 | 滑杆和方孔太紧，有毛刺 | 用刀刮一圈方孔，抹一点凡士林 |
| 按钮能晃动 / 有咔哒声 | 连接销没插到底，或销钉太松 | 把销钉压到底；销钉缠一圈胶带 |
| 舵机一直嗡嗡响、发热 | 行程超过限位，舵机在硬顶 | 把按下角度调小（比如 22 改成 18） |
| 按钮拉进去之后回不来 | 曲柄夹紧螺丝松了，曲柄在轴上打滑 | 重新对零（第 7 步）并拧紧螺丝 |
| 上下按钮行程差很多 | 曲柄装的角度不同 | 分别重新对零，或分别调固件角度 |
| 面板固定处裂了 | M3 螺丝拧太猛 | 换大一号螺丝，或滴一点胶（这里允许用胶） |

---

## 12. 已知限制（先说明，免得踩坑）

1. **这是演示模型**。面板、按钮都是打印的，不代表真电梯按钮的尺寸/行程。
2. **舵机尺寸是查手册的**（MG90S：32.5 × 22.8 × 28.4 等）。不同批次的舵机可能有 0.5 mm 差异，装之前量一下耳朵孔距（27.7 mm）。
3. **舵机轴的防脱**靠曲柄夹紧螺丝的夹紧力。如果实测会往轴向滑出，可在花键上缠一圈生料带/透明胶带再压曲柄。
4. **按钮回位**靠舵机。断电后按钮会停在当前位置，不会自己弹回。
5. 打印件的孔会比设计值小 0.1~0.2 mm（材料收缩 + 挤出膨胀），所以上面表格里的孔都留了正公差。

---

## 13. 想改的话，改哪里

所有尺寸都写在 `cad/build.py` 开头的参数区，改完重跑：

```
py -3 build.py
```

它会自动：重新生成 8 个 STL、7 张预览图、一份 `参数与校验报告.md`（含全行程干涉检查结果）。
**如果改完干涉检查不通过，报告里会直接告诉你是哪个零件和哪个零件撞了。**
