Mocen-Bear/Mocen_Elevator_Ctrl/(commit log)

2026-11-01 Initial commit: elevator Android app, ESP32 firmware, docs and deck
2026-11-01 docs(esp32): add Arduino environment handover
2026-11-01 docs(esp32): add environment setup report
2026-11-01 feat(preview): add navigation and elevator UI prototypes
2026-11-01 feat(preview): add BLE, RSSI and LED reading simulators
2026-11-01 mech: add press mechanism CAD scripts and notes
2026-11-01 mech: add STL parts
    [01_底座.stl, 02_面板.stl, 03_按钮_上.stl, 04_按钮_下.stl, 05_滑块.stl, 06_曲柄.stl, 07_销钉.stl, 08_连接销.stl]
2026-11-02 docs: add handoff package for shaft model
2026-11-05 docs(preview): add prototype pages readme
2026-11-05 docs(spec): add table of contents to shaft model spec
2026-11-06 docs: restructure write-ups into 项目资料
2026-11-06 preview: rename deck pages and refresh prototype index
2026-11-08 docs: fix references to the removed elevator_3F sketch
    [chime_node.ino]
2026-11-10 docs: align the handover notes with the current floor layout
    The shaft is B/1F/2F/3F and the call devices sit on 1F and 2F, so the
    examples, the up/down table and the on-site steps now use those floors.
2026-11-10 docs(api): update the examples to the B/1F/2F/3F floors
    The HTTP examples still advertised callable floors 2F/3F and a 1F-4F
    shaft. Both now match what the app actually serves: callable 1F/2F inside
    the B/1F/2F/3F shaft.
2026-11-10 docs: align the report with the B/1F/2F/3F shaft
    Floor names, device names, the ASCII diagram, the UI description and the
    appendix parameter table now describe the shaft the app actually renders:
    B/1F/2F/3F with call devices on 1F and 2F.
2026-11-10 docs(ble): move the protocol examples to the 1F/2F nodes
    Device names, advertised floors, notify payloads and the Swift snippets
    follow the two boards that exist now (ELEV-1F and ELEV-2F). The package
    copy had one duplicated board line; both now list 1F and 2F.
2026-11-10 docs(shaft): update the 3D shaft notes to the B/1F/2F/3F model
    Floor indices, the view window, the chime examples and the device names
    now match the four slabs the app draws and the two floors we can call from.
2026-11-10 docs: sync the feature sheets and slides with the current floors
    Capability notes, the intro doc, the demo storyboard, the 3D model brief
    and one line of the install notes still said 2F/3F inside a 1F-4F shaft.
2026-11-10 preview: relabel the mock pages to the B/1F/2F/3F shaft
    Floor arrays, legends, buttons and hints in the five offline previews now
    use the same four floors and the same two callable floors as the app.
2026-11-10 docs(ios): move the integration notes to the 1F/2F nodes
    The iOS hand-off docs, the on-site checklist and the web BLE console still
    named ELEV-2F/ELEV-3F inside a 1F-4F shaft.
